dnotq/dnotq_kicad_lib/images/JLCPCB_part-pos_format.png

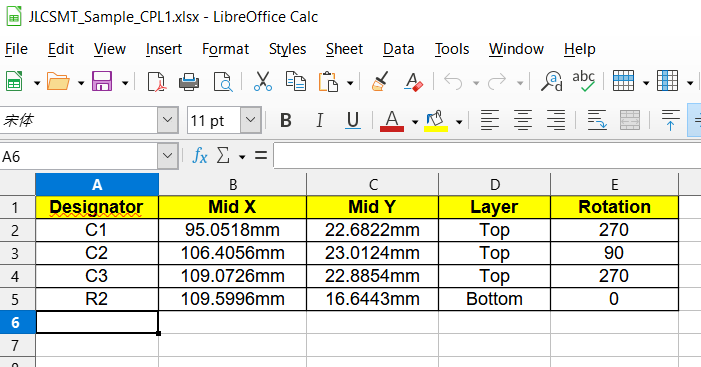
images/JLCPCB_part-pos_format.png
