dnotq/dnotq_kicad_lib/images/kicad_using_sym_foot.png

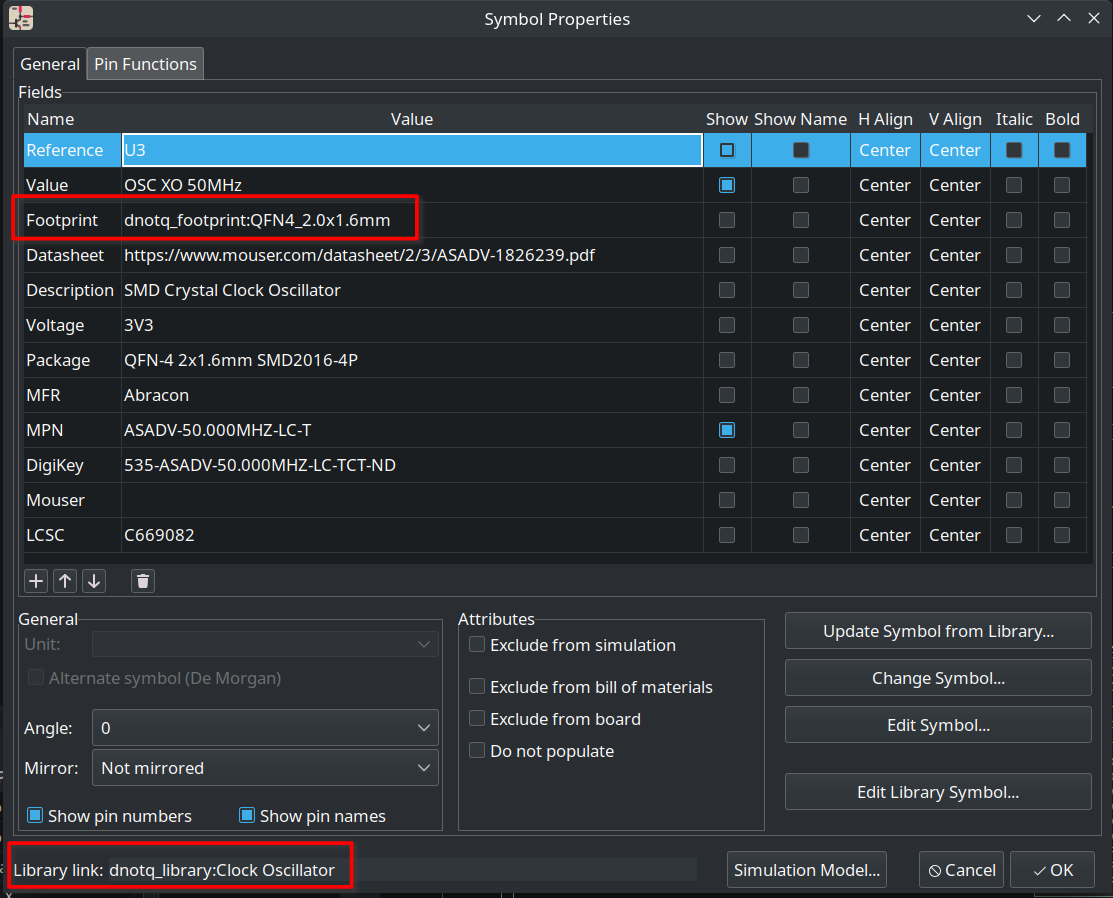
images/kicad_using_sym_foot.png
