dnotq/dnotq_kicad_lib/images/symbol_field_ref.png

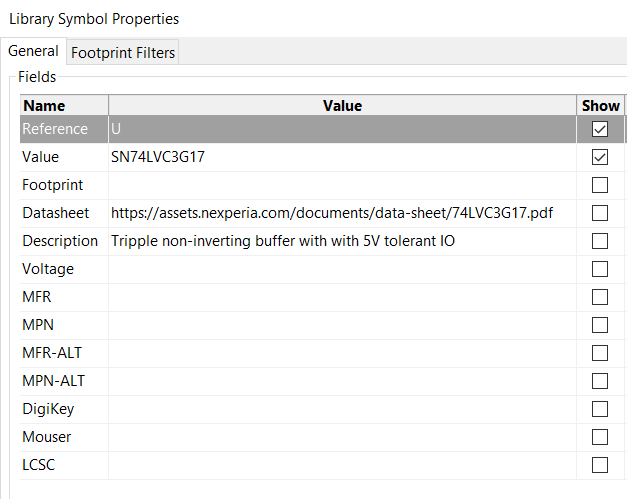
images/symbol_field_ref.png
