dnotq/dnotq_kicad_lib/models/Seiko_Epston_FC-135R_crystal.step

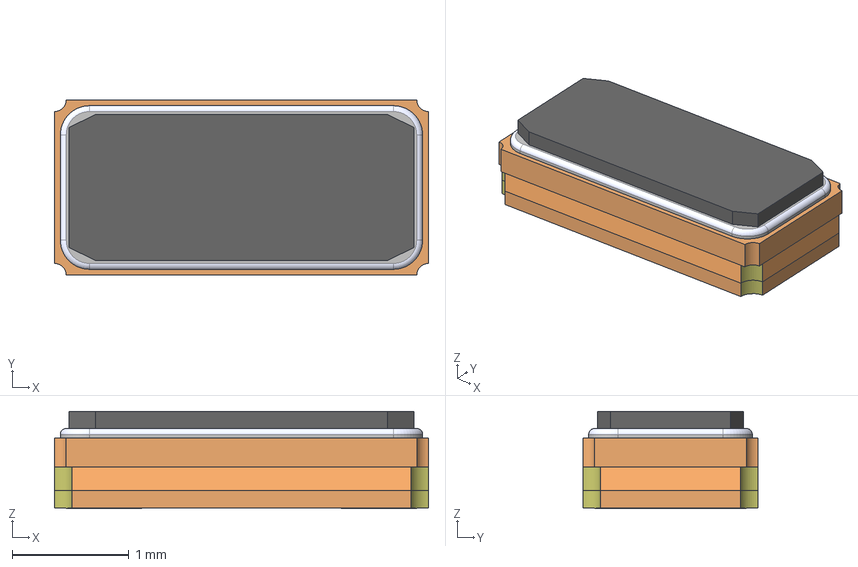
[picture p8: CAD file, 2026-05-12]
models/Seiko_Epston_FC-135R_crystal.step
3.20 x 1.50 x 0.831 mm
FC-135
FC-136
FC-137
FC-138
FC-139
FC-140
FC-141
FC-142
FC-143
FC-144
