dnotq/dnotq_kicad_lib/models/Molex_053261-0271_2pos_1.25mm_ra_smd.step

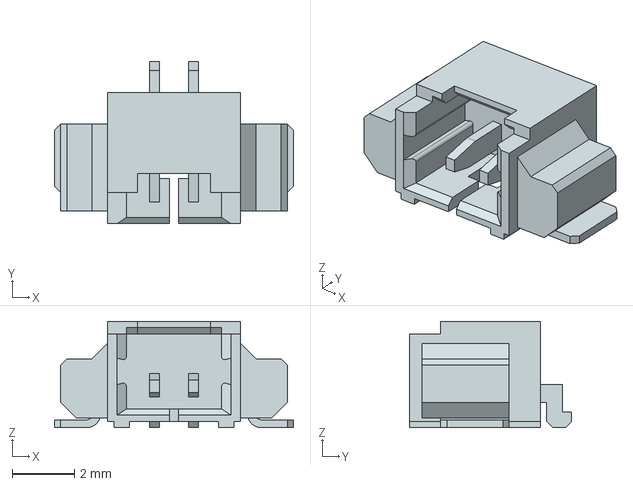
[picture p9: CAD file, 2026-05-12]
models/Molex_053261-0271_2pos_1.25mm_ra_smd.step
7.65 x 5.20 x 3.40 mm
