dnotq/dnotq_kicad_lib/models/Seiko_Epson_MC-306_8x3.8mm.step

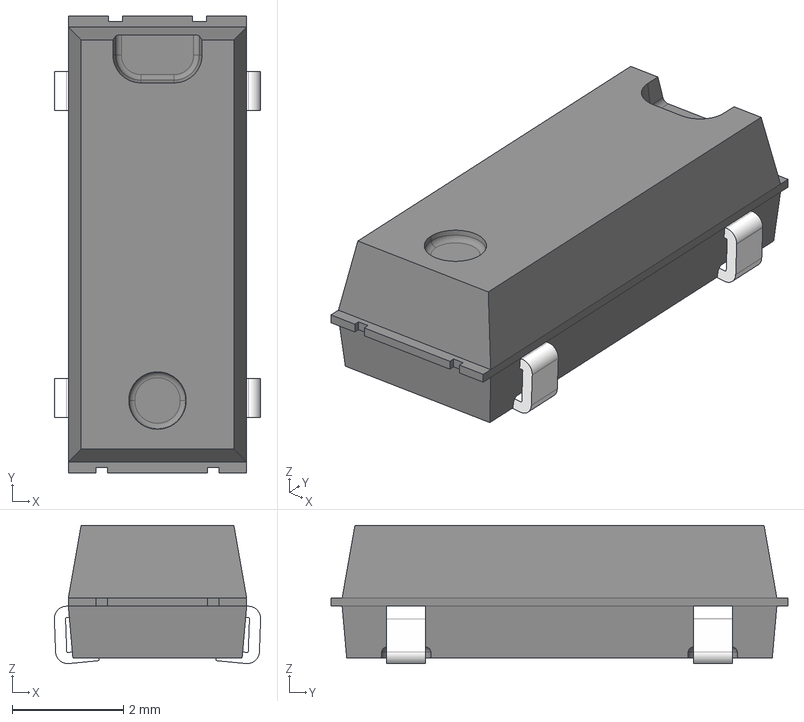
[picture p10: CAD file, 2026-05-12]
models/Seiko_Epson_MC-306_8x3.8mm.step
3.70 x 8.20 x 2.48 mm
