dnotq/dnotq_kicad_lib/models/D_SOD-882.step

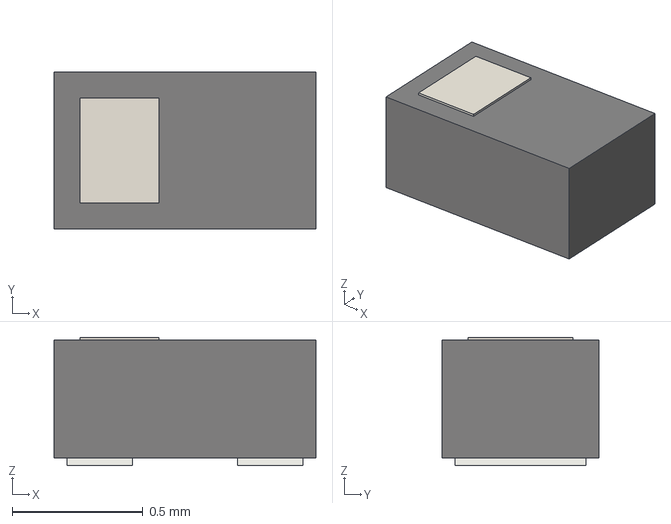
[picture p11: CAD file, 2025-04-14]
models/D_SOD-882.step
1.00 x 0.6 x 0.49 mm
