dnotq/dnotq_kicad_lib/models/VQFP-100_14x14mm_P0.5mm.step

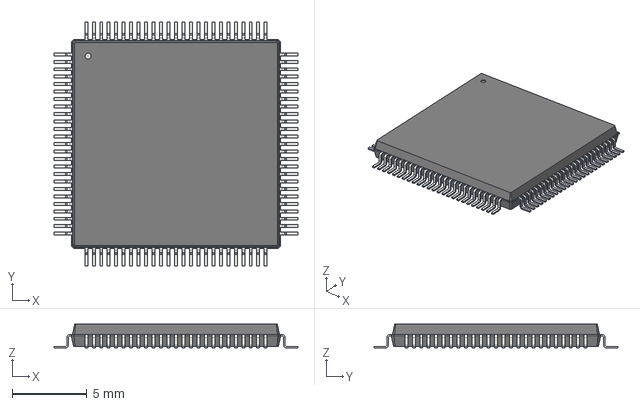
[picture p12: CAD file, 2025-04-14]
models/VQFP-100_14x14mm_P0.5mm.step
16.3 x 16.3 x 1.60 mm
