dnotq/dnotq_kicad_lib/models/C_0201_0603Metric.step

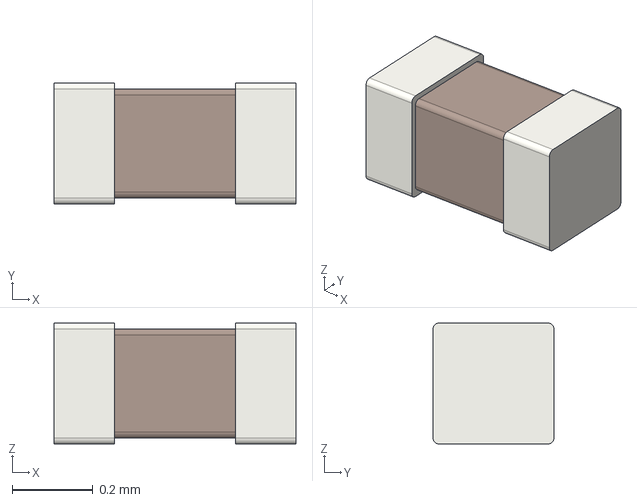
[picture p13: CAD file, 2025-04-14]
models/C_0201_0603Metric.step
0.6 x 0.3 x 0.3 mm
