dnotq/dnotq_kicad_lib/models/SOT-323_SC-70.step

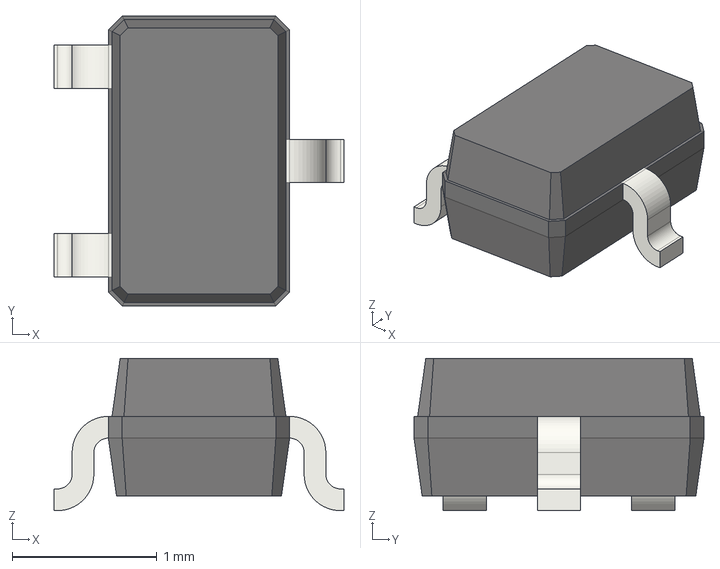
[picture p14: CAD file, 2025-04-14]
models/SOT-323_SC-70.step
2.00 x 2.00 x 1.05 mm
