dnotq/dnotq_kicad_lib/models/R_0603_1608Metric.step

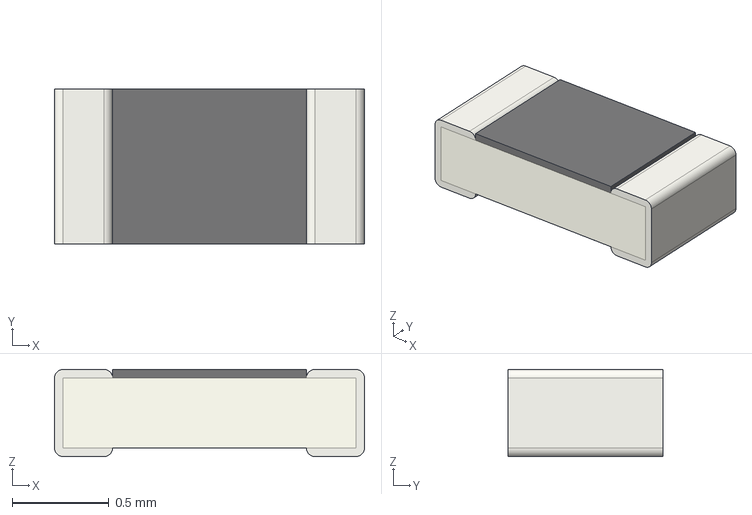
[picture p16: CAD file, 2025-04-14]
models/R_0603_1608Metric.step
1.60 x 0.8 x 0.45 mm
