dnotq/dnotq_kicad_lib/models/WSON-6-1EP_2x2mm_P0.65mm_EP1x1.6mm.step

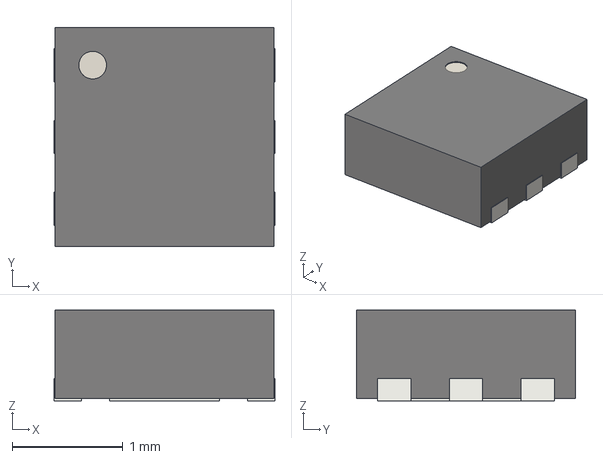
[picture p17: CAD file, 2025-04-14]
models/WSON-6-1EP_2x2mm_P0.65mm_EP1x1.6mm.step
2.00 x 1.98 x 0.82 mm
