dnotq/dnotq_kicad_lib/models/PinSocket_2x06_P2.54mm_Horizontal.step

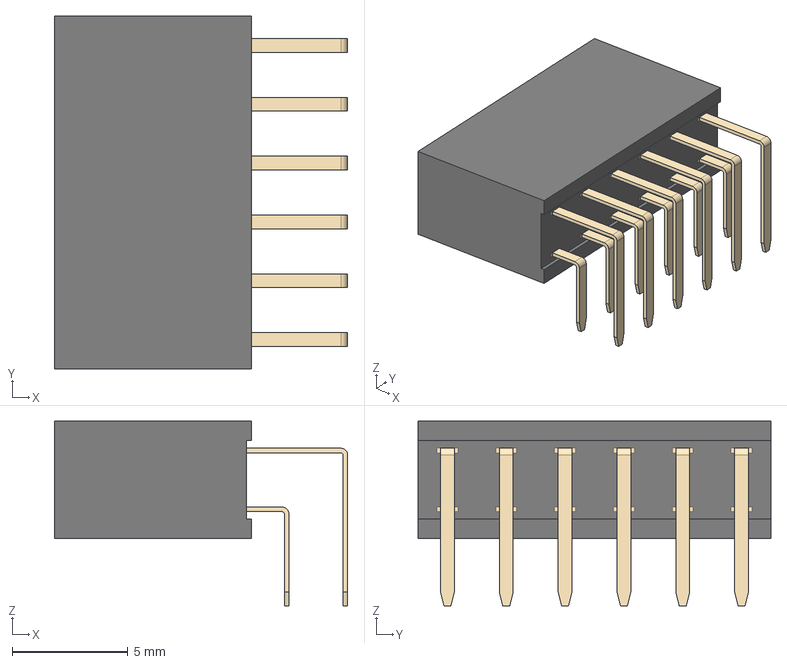
[picture p18: CAD file, 2025-04-14]
models/PinSocket_2x06_P2.54mm_Horizontal.step
12.7 x 15.2 x 7.98 mm
