dnotq/dnotq_kicad_lib/models/R_0612_1632Metric.step

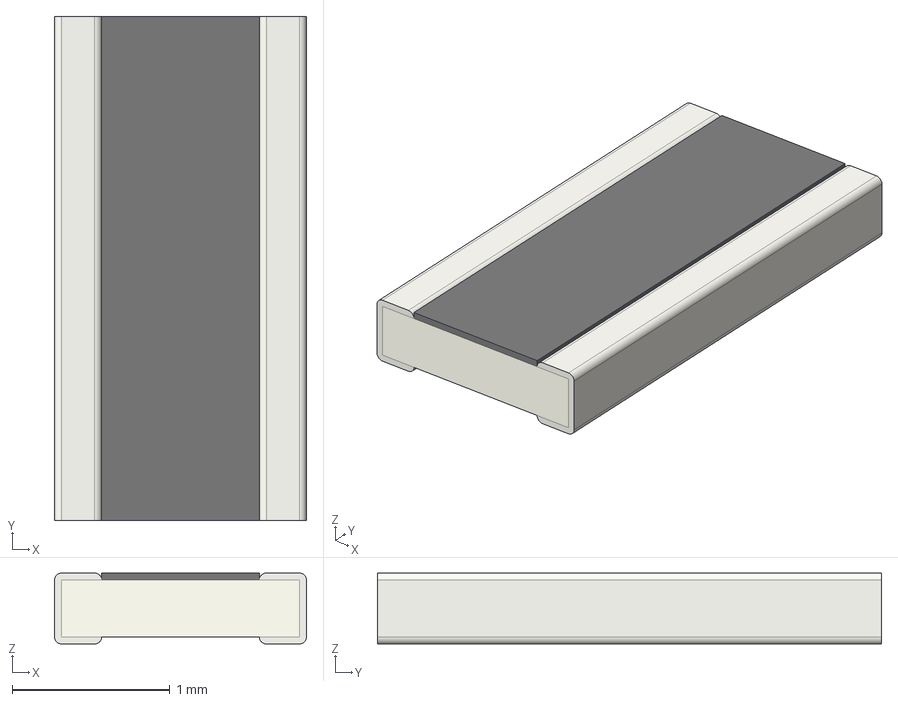
[picture p19: CAD file, 2025-04-14]
models/R_0612_1632Metric.step
1.60 x 3.20 x 0.45 mm
