dnotq/dnotq_kicad_lib/models/C_0402_1005Metric.step

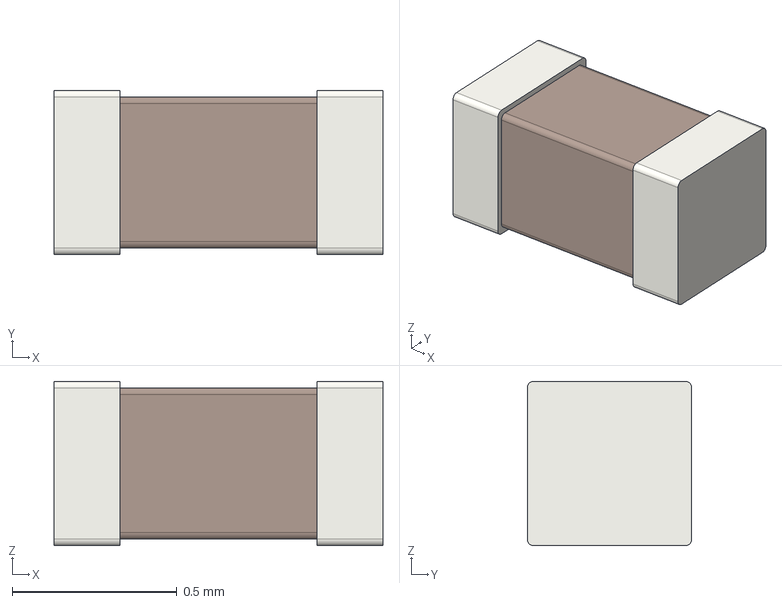
[picture p20: CAD file, 2025-04-14]
models/C_0402_1005Metric.step
1.00 x 0.5 x 0.5 mm
