dnotq/dnotq_kicad_lib/models/VSSOP-8_2.3x2mm_P0.5mm.step

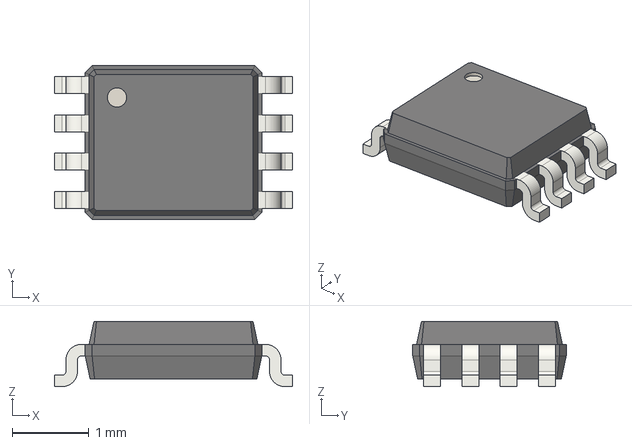
[picture p21: CAD file, 2025-04-14]
models/VSSOP-8_2.3x2mm_P0.5mm.step
3.10 x 2.00 x 0.85 mm
