dnotq/dnotq_kicad_lib/models/SOT-23.step

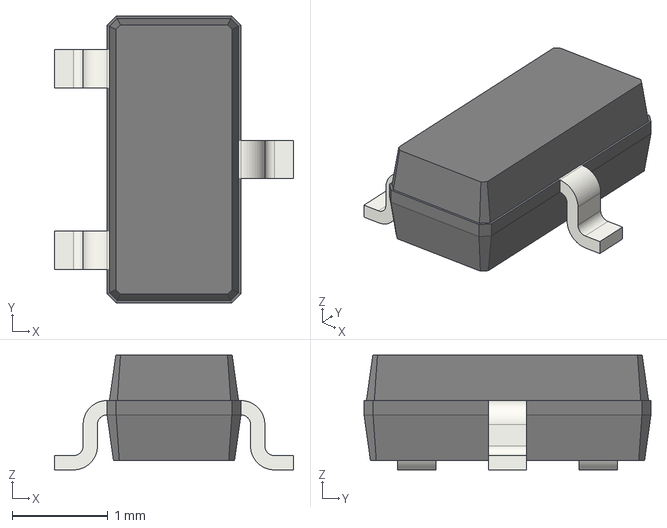
[picture p22: CAD file, 2025-04-14]
models/SOT-23.step
2.50 x 3.00 x 1.20 mm
