dnotq/dnotq_kicad_lib/models/DFN-6_1.2x1.3mm_P0.4mm.step

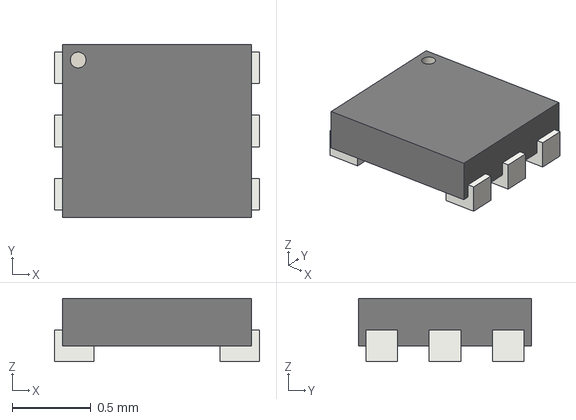
[picture p23: CAD file, 2025-04-14]
models/DFN-6_1.2x1.3mm_P0.4mm.step
1.30 x 1.10 x 0.4 mm
