dnotq/dnotq_kicad_lib/models/R_0402_1005Metric.step

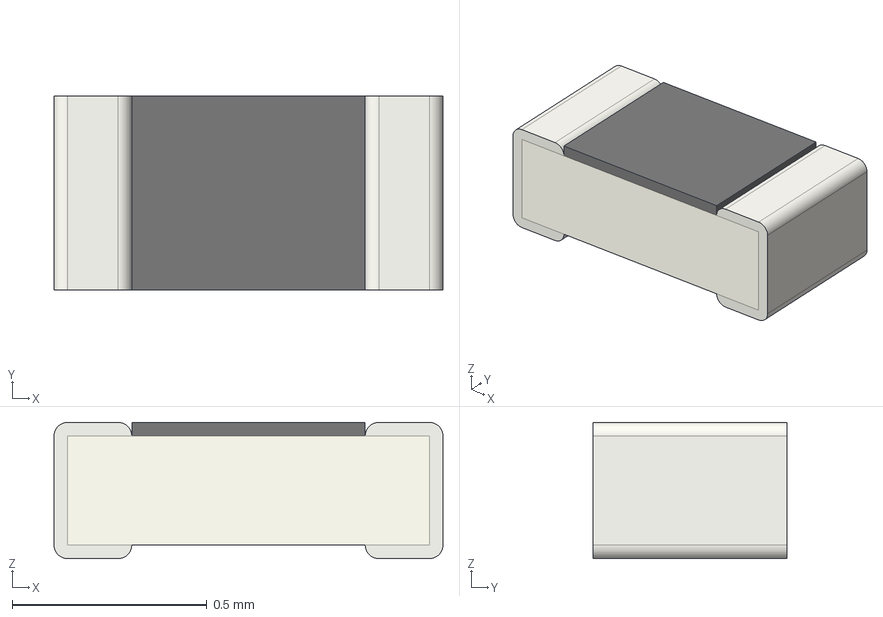
[picture p24: CAD file, 2025-04-14]
models/R_0402_1005Metric.step
1.00 x 0.5 x 0.35 mm
