dnotq/dnotq_kicad_lib/models/C_0603_1608Metric.step

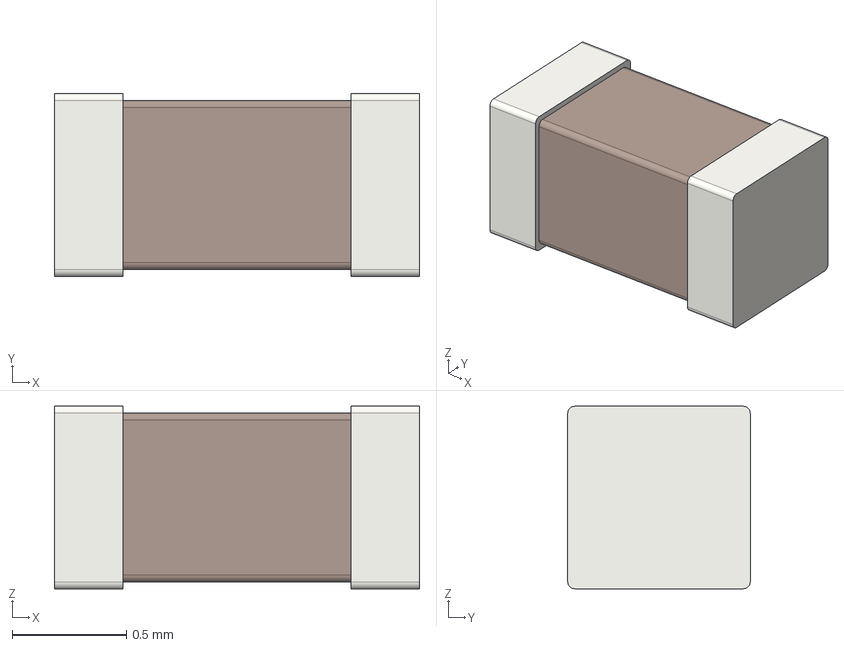
[picture p25: CAD file, 2025-04-14]
models/C_0603_1608Metric.step
1.60 x 0.8 x 0.8 mm
