dnotq/dnotq_kicad_lib/models/R_Array_Convex_4x0402.step

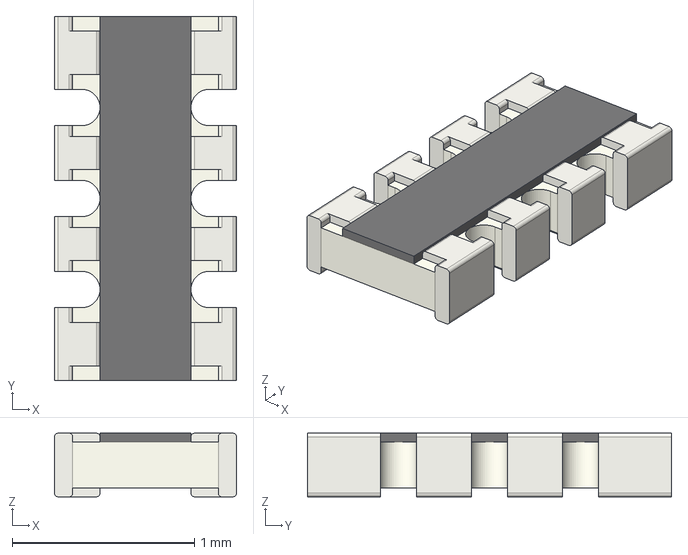
[picture p26: CAD file, 2025-04-14]
models/R_Array_Convex_4x0402.step
1.00 x 2.00 x 0.35 mm
