dnotq/dnotq_kicad_lib/models/R_0201_0603Metric.step

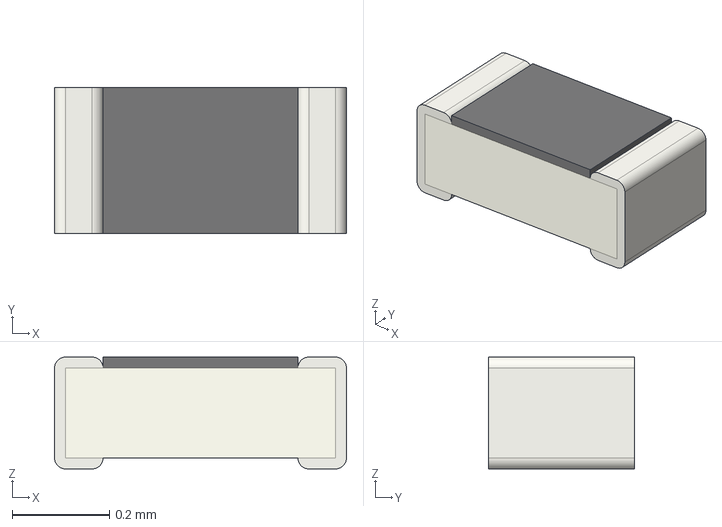
[picture p27: CAD file, 2025-04-14]
models/R_0201_0603Metric.step
0.6 x 0.3 x 0.23 mm
