dnotq/dnotq_kicad_lib/models/TSSOP-20_4.4x6.5mm_P0.65mm.step

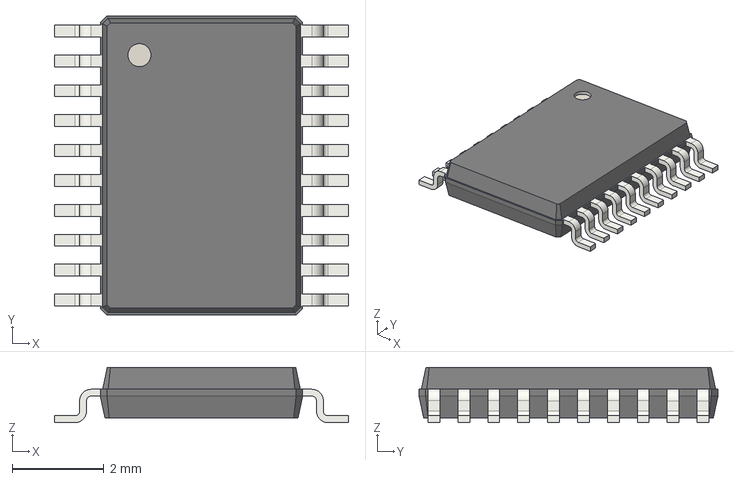
[picture p28: CAD file, 2025-04-14]
models/TSSOP-20_4.4x6.5mm_P0.65mm.step
6.40 x 6.50 x 1.20 mm
