dnotq/dnotq_kicad_lib/models/TQFP-32_7x7mm_P0.8mm.step

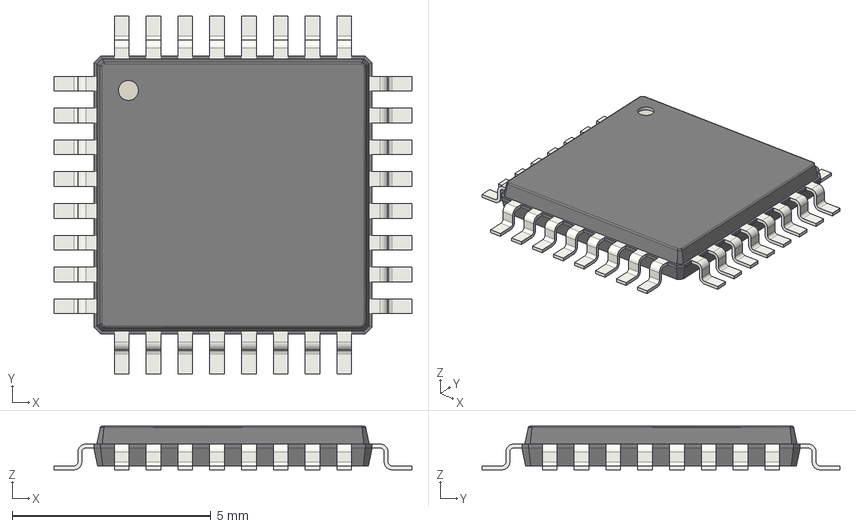
[picture p29: CAD file, 2025-04-14]
models/TQFP-32_7x7mm_P0.8mm.step
9.00 x 9.00 x 1.10 mm
