dnotq/dnotq_kicad_lib/models/USB_Micro-B_Molex_47346-0001.step

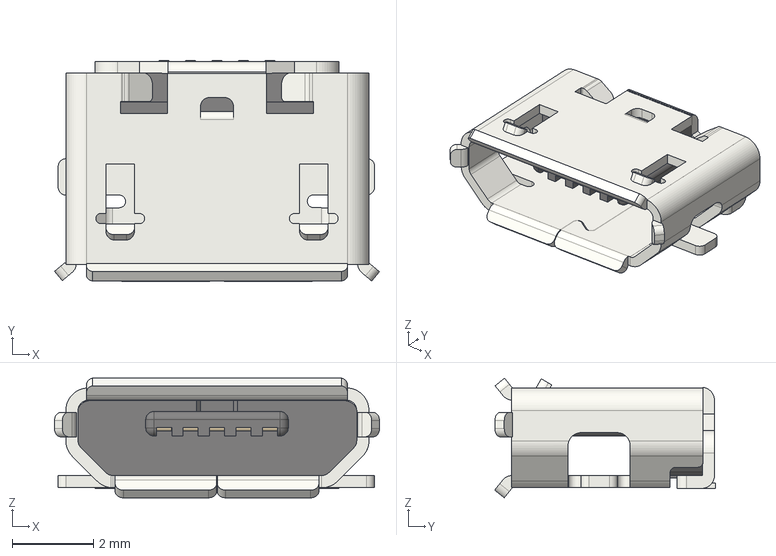
[picture p30: CAD file, 2025-04-14]
models/USB_Micro-B_Molex_47346-0001.step
7.98 x 5.42 x 2.94 mm
