dnotq/dnotq_kicad_lib/models/LED_D3.0mm.step

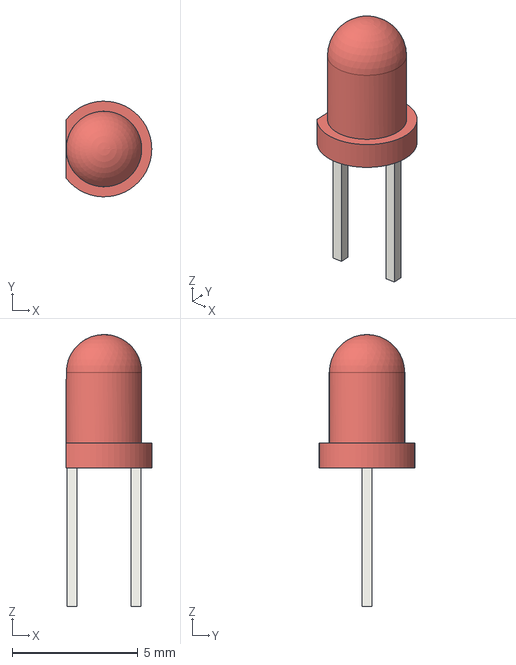
[picture p31: CAD file, 2025-04-14]
models/LED_D3.0mm.step
3.40 x 3.80 x 10.8 mm
