dnotq/dnotq_kicad_lib/models/C_0805_2012Metric.step

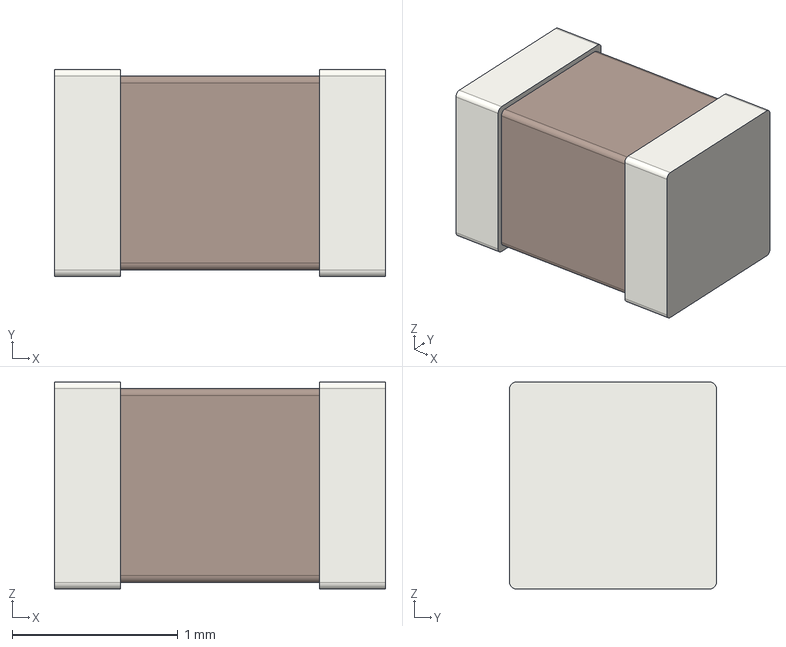
[picture p32: CAD file, 2025-04-14]
models/C_0805_2012Metric.step
2.00 x 1.25 x 1.25 mm
