dnotq/dnotq_kicad_lib/models/D_SOD-523.step

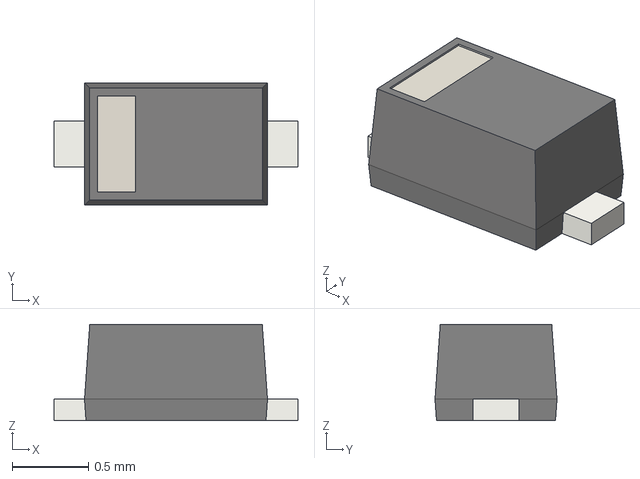
[picture p33: CAD file, 2025-04-14]
models/D_SOD-523.step
1.60 x 0.8 x 0.63 mm
