dnotq/dnotq_kicad_lib/models/TO-263-3_TabPin2.step

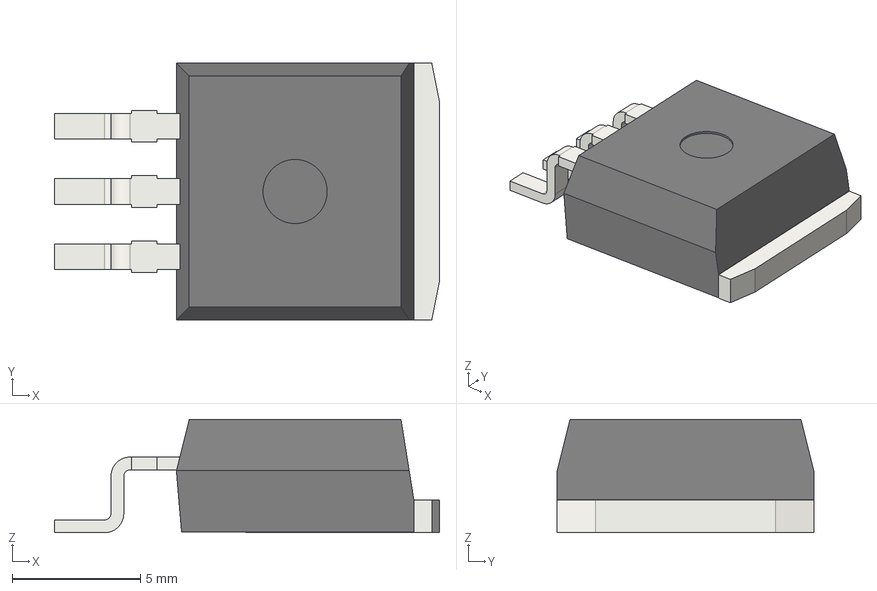
[picture p34: CAD file, 2025-04-14]
models/TO-263-3_TabPin2.step
15.0 x 10.0 x 4.42 mm
a52d3817-9c39-11ed-93f0-dde97e994e83_part
a52d3818-9c39-11ed-93f0-dde97e994e83_part
a52d3819-9c39-11ed-93f0-dde97e994e83_part
