dnotq/dnotq_kicad_lib/models/HIROSE_FH34SRJ-22S-0.5SH.step

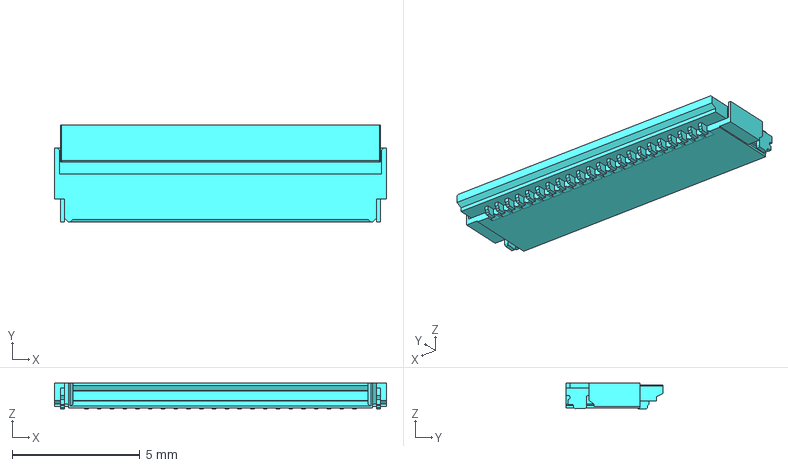
[picture p35: CAD file, 2023-02-13]
models/HIROSE_FH34SRJ-22S-0.5SH.step
13.0 x 3.80 x 1.00 mm
