dnotq/dnotq_kicad_lib/models/3M_TEXTOOL_ZIF_40DIP.step

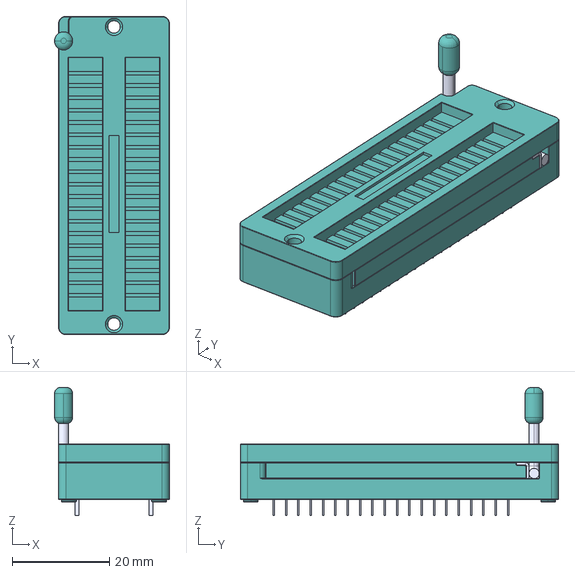
[picture p36: CAD file, 2023-02-13]
models/3M_TEXTOOL_ZIF_40DIP.step
23.7 x 65.5 x 26.4 mm
