dnotq/dnotq_kicad_lib/models/CUI_SJ-3523-SMT-TR.step

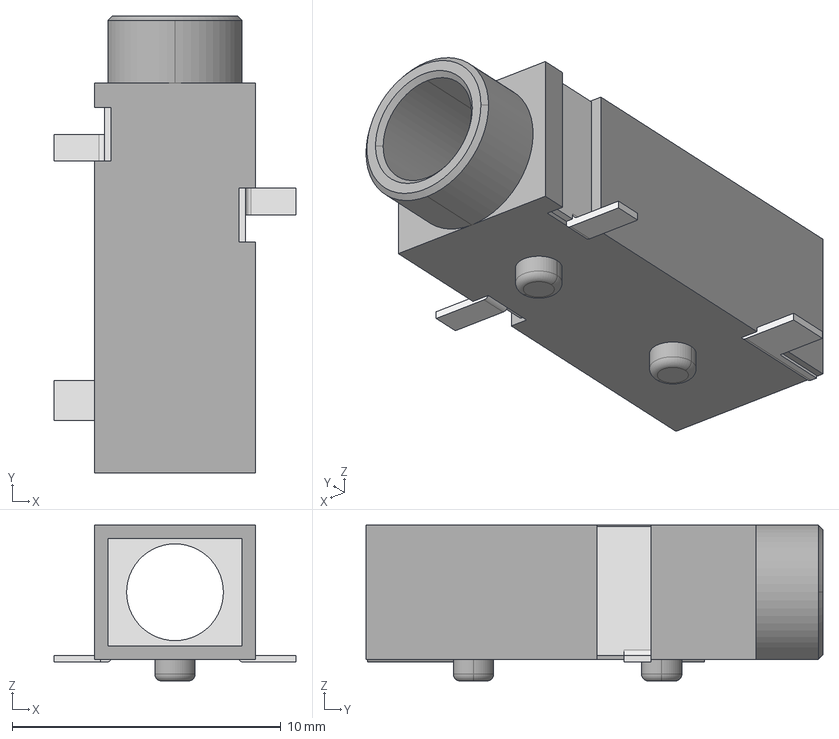
[picture p37: CAD file, 2022-12-09]
models/CUI_SJ-3523-SMT-TR.step
9.00 x 17.0 x 5.80 mm
