dnotq/dnotq_kicad_lib/models/LED_0603_1608Metric.step

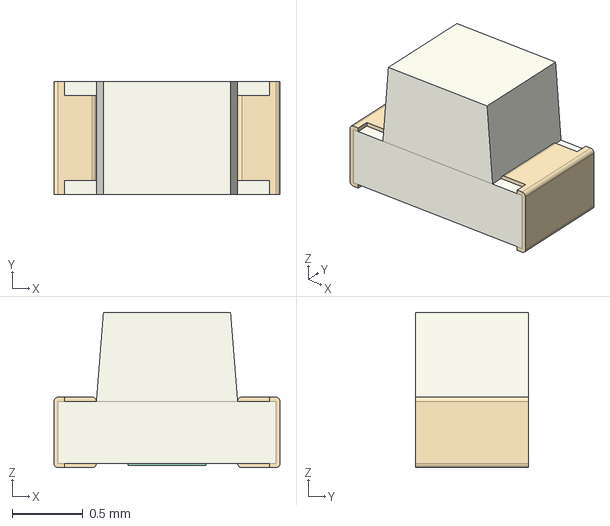
[picture p38: CAD file, 2022-12-09]
models/LED_0603_1608Metric.step
1.60 x 0.8 x 1.10 mm
