dnotq/dnotq_kicad_lib/models/UDFN8_1.95x1.0.step

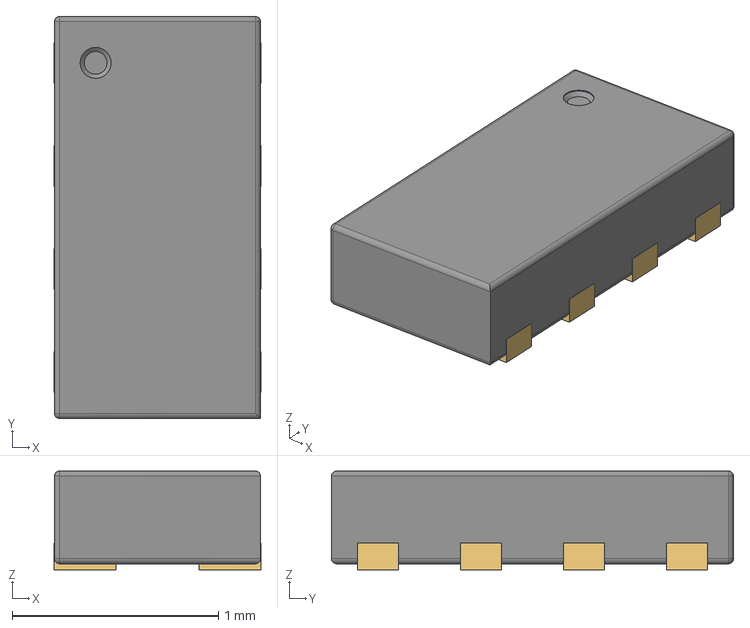
[picture p39: CAD file, 2022-12-09]
models/UDFN8_1.95x1.0.step
1.00 x 1.95 x 0.48 mm
