dnotq/dnotq_kicad_lib/models/VSSOP-8_3.0x3.0mm_P0.65mm.step

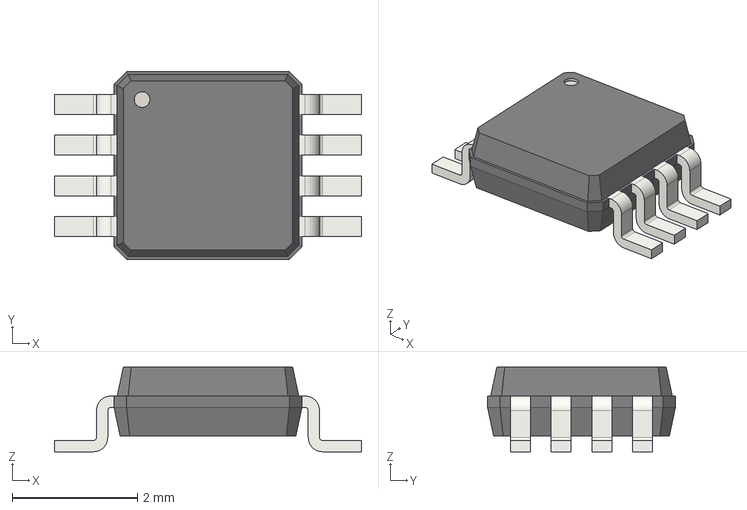
[picture p40: CAD file, 2022-12-09]
models/VSSOP-8_3.0x3.0mm_P0.65mm.step
4.90 x 3.00 x 1.35 mm
