dnotq/dnotq_kicad_lib/models/molex_FFC_20_P0.5.step

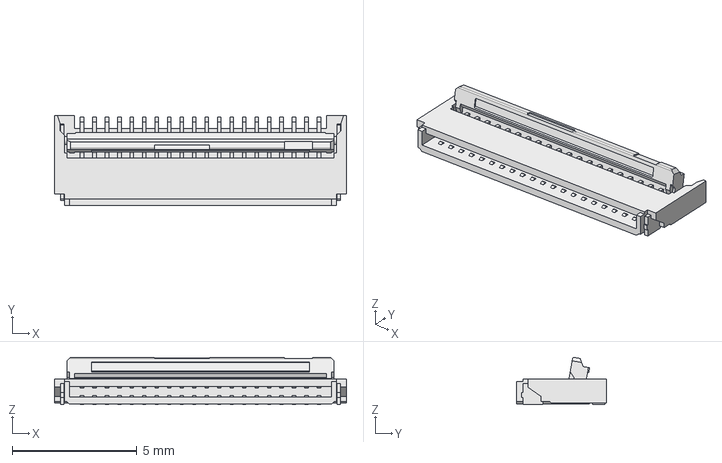
[picture p41: CAD file, 2022-12-09]
models/molex_FFC_20_P0.5.step
11.7 x 3.60 x 1.90 mm
