dnotq/dnotq_kicad_lib/models/PVQFN-N24.step

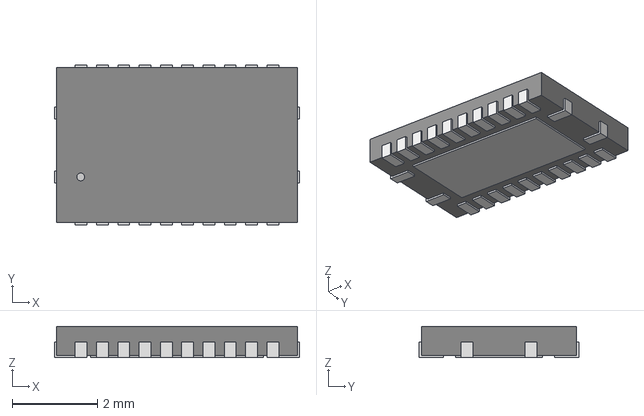
[picture p42: CAD file, 2022-12-09]
models/PVQFN-N24.step
5.75 x 3.75 x 0.739 mm
