dnotq/dnotq_kicad_lib/models/EDAC_DSUB_HD15_THIN_FEMALE.step

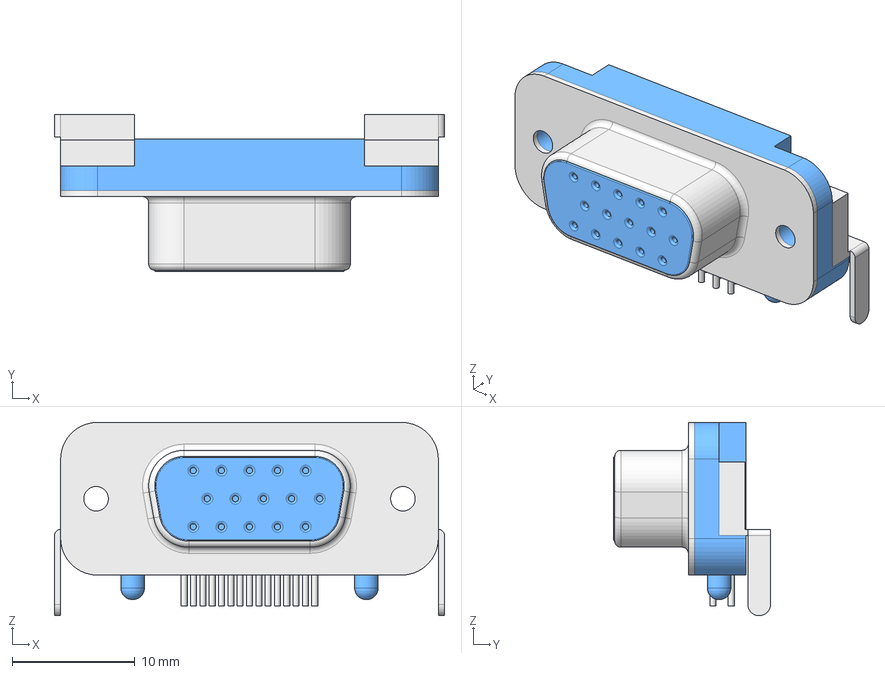
[picture p43: CAD file, 2022-12-09]
models/EDAC_DSUB_HD15_THIN_FEMALE.step
31.8 x 12.8 x 15.7 mm
