dnotq/dnotq_kicad_lib/models/SMD_DIP4.step

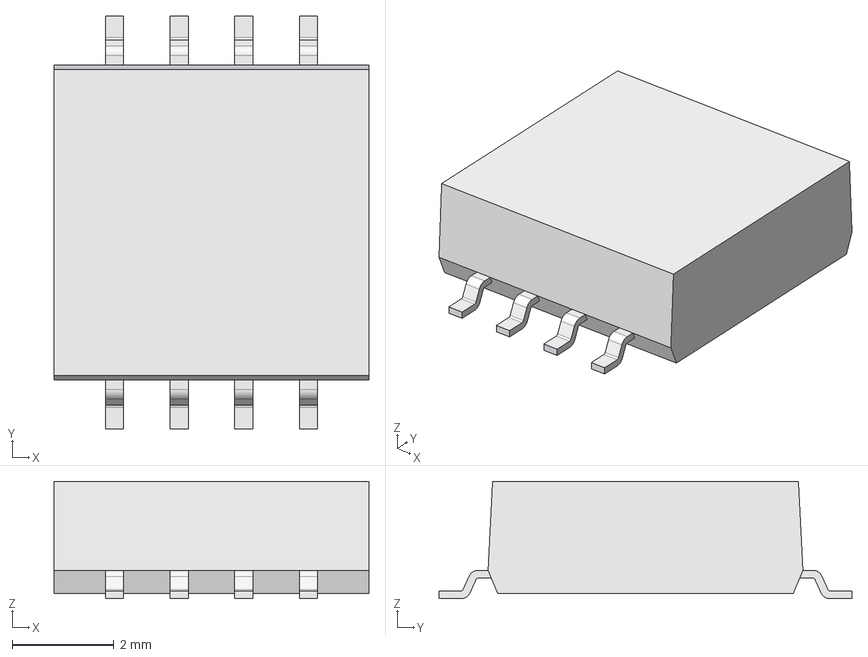
[picture p44: CAD file, 2022-12-09]
models/SMD_DIP4.step
6.20 x 8.13 x 2.31 mm
