dnotq/dnotq_kicad_lib/models/MOLEX_FPC-22_P0.5.step

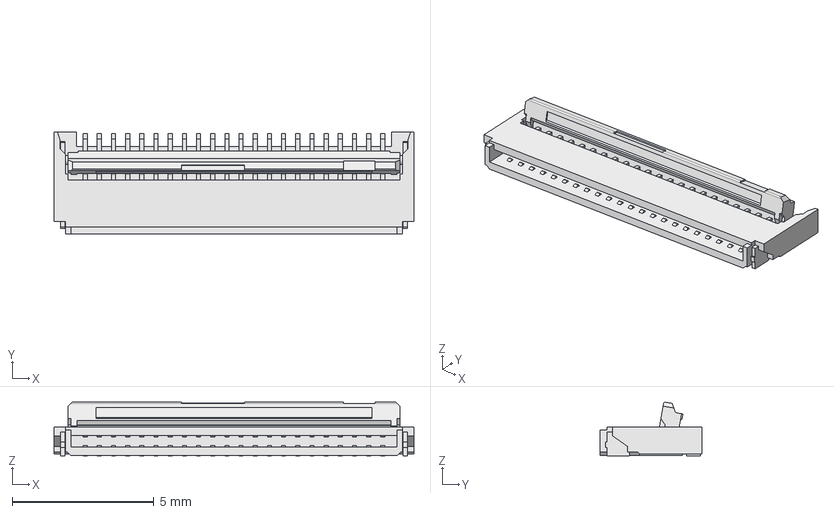
[picture p45: CAD file, 2022-12-09]
models/MOLEX_FPC-22_P0.5.step
12.7 x 3.60 x 1.89 mm
