dnotq/dnotq_kicad_lib/models/CK_SWITCH_101M2S3CQE011.step

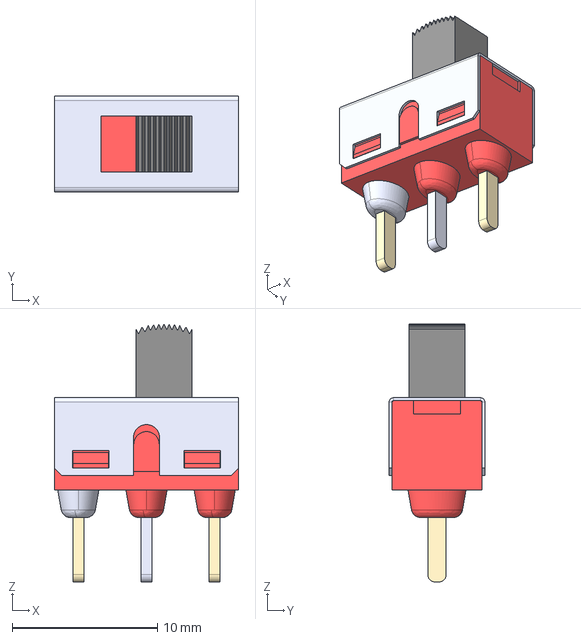
[picture p46: CAD file, 2022-12-09]
models/CK_SWITCH_101M2S3CQE011.step
12.7 x 6.60 x 17.8 mm
