dnotq/dnotq_kicad_lib/models/amp_fci_tmds_type_a.step

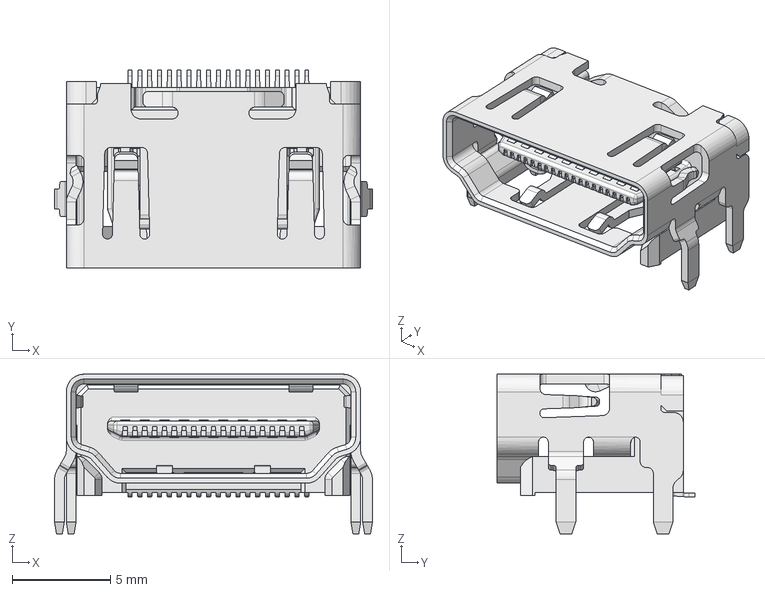
[picture p47: CAD file, 2022-12-09]
models/amp_fci_tmds_type_a.step
16.2 x 10.1 x 8.13 mm
