dnotq/dnotq_kicad_lib/models/TSSOP-8_4.4x3mm_P0.65mm.step

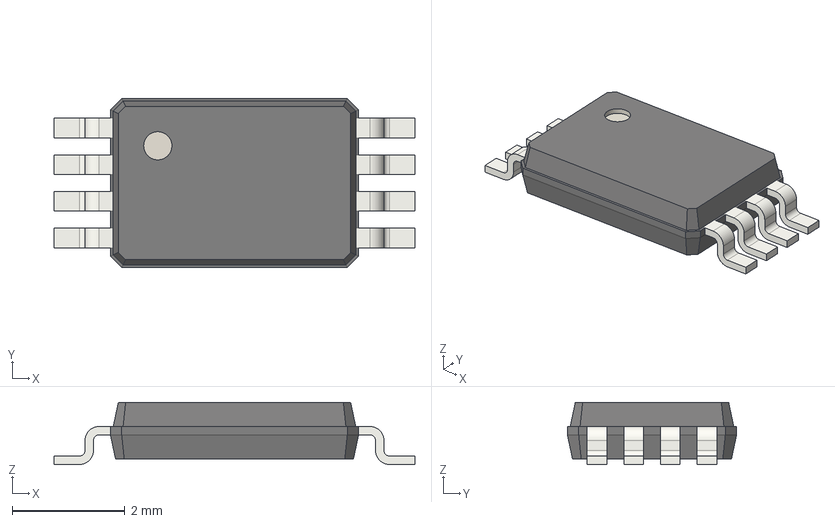
[picture p48: CAD file, 2022-12-09]
models/TSSOP-8_4.4x3mm_P0.65mm.step
6.40 x 3.00 x 1.10 mm
