dnotq/dnotq_kicad_lib/models/TSM_102_01_L_SH_A_cp.step

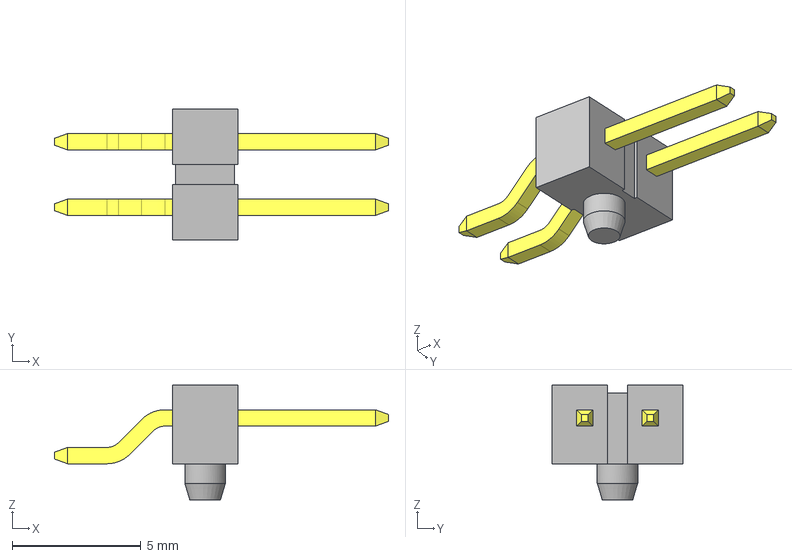
[picture p49: CAD file, 2022-12-09]
models/TSM_102_01_L_SH_A_cp.step
13.0 x 5.08 x 4.45 mm
