dnotq/dnotq_kicad_lib/models/wurth_tact_switch_SPST-NO.step

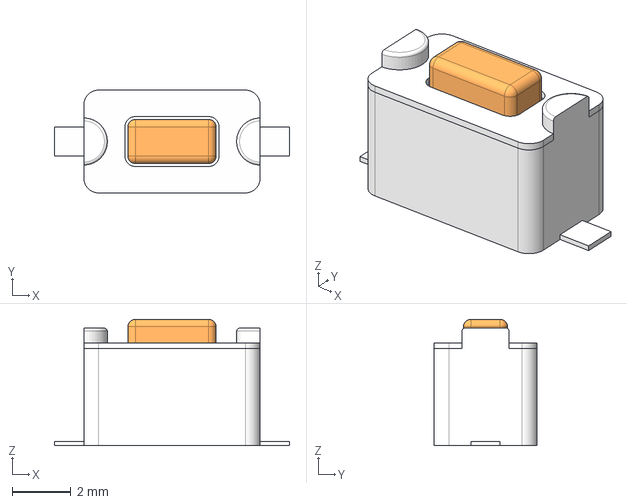
[picture p50: CAD file, 2022-12-09]
models/wurth_tact_switch_SPST-NO.step
8.00 x 3.50 x 4.30 mm
