dnotq/dnotq_kicad_lib/models/ASE_QFN4_3.2x2.5.step

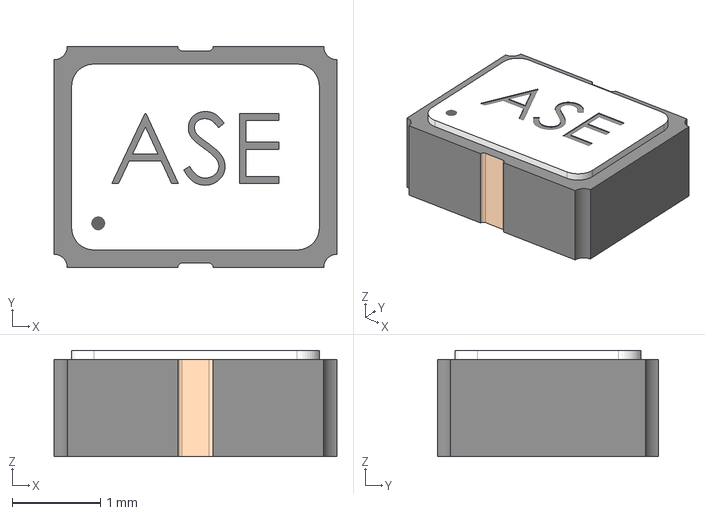
[picture p51: CAD file, 2022-12-09]
models/ASE_QFN4_3.2x2.5.step
3.20 x 2.50 x 1.20 mm
