dnotq/dnotq_kicad_lib/models/Keystone_621.step

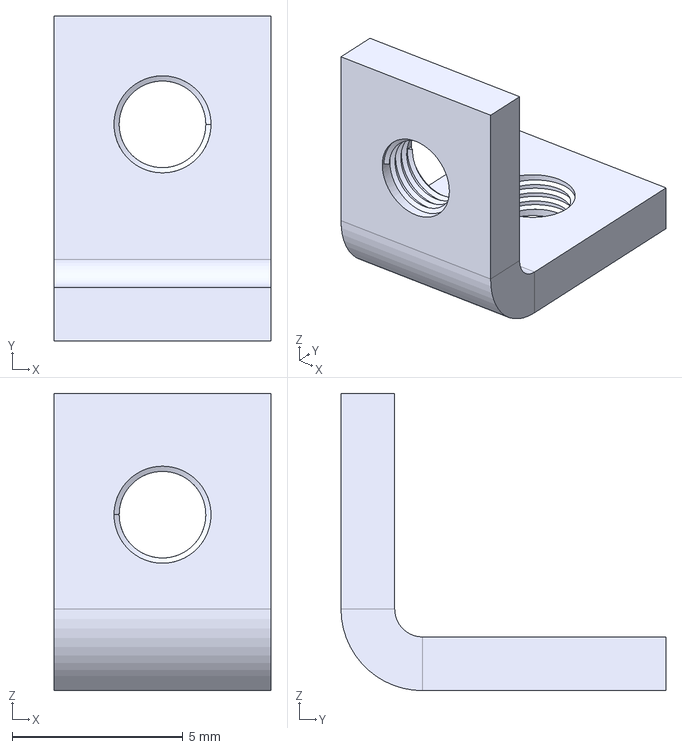
[picture p52: CAD file, 2022-12-09]
models/Keystone_621.step
6.35 x 9.53 x 8.71 mm
