dnotq/dnotq_kicad_lib/models/DSBGA-8_YZT.step

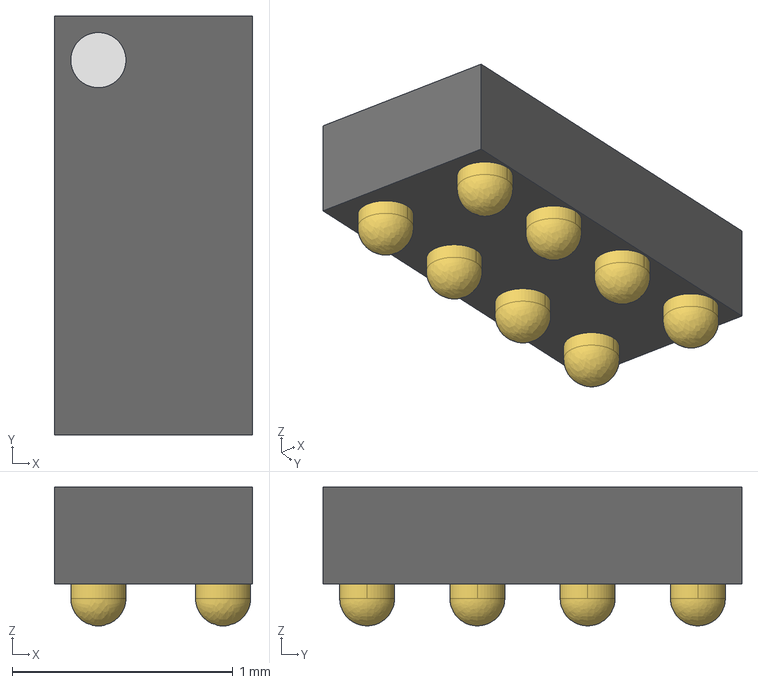
[picture p53: CAD file, 2022-12-09]
models/DSBGA-8_YZT.step
0.9 x 1.90 x 0.63 mm
