dnotq/dnotq_kicad_lib/models/JST_ZH_S2B-ZR-SM4A-TF.step

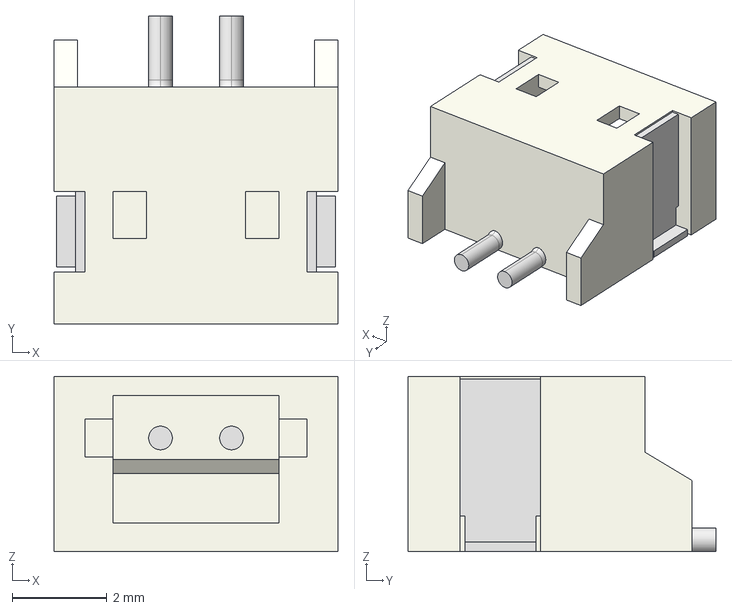
[picture p54: CAD file, 2022-12-09]
models/JST_ZH_S2B-ZR-SM4A-TF.step
6.00 x 6.50 x 3.70 mm
