dnotq/dnotq_kicad_lib/models/DIP24-PCB-PINS.step

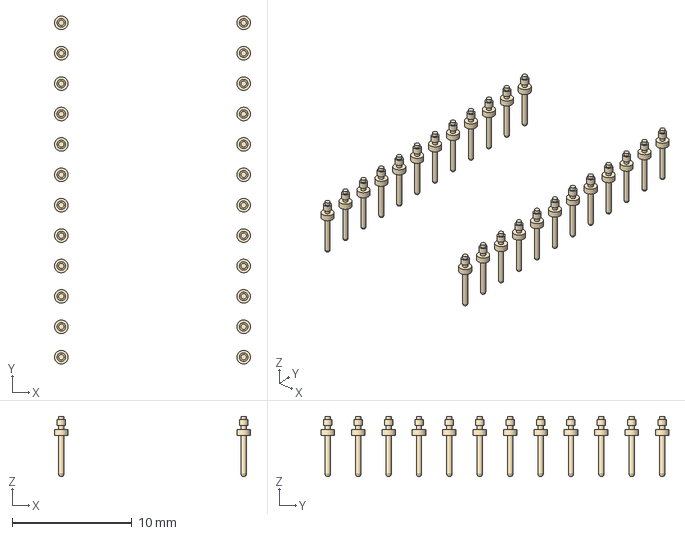
[picture p55: CAD file, 2022-12-09]
models/DIP24-PCB-PINS.step
16.4 x 29.1 x 5.05 mm
