dnotq/dnotq_kicad_lib/models/TSOT-23-6.step

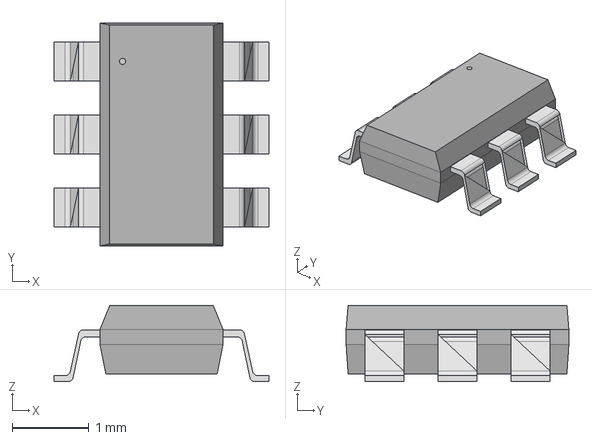
[picture p56: CAD file, 2022-12-09]
models/TSOT-23-6.step
2.79 x 2.90 x 0.993 mm
