dnotq/dnotq_kicad_lib/models/TFBGA_36and48_6x8mm.step

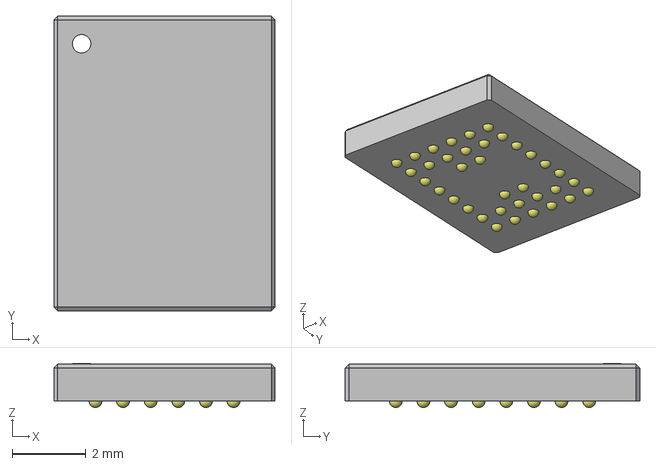
[picture p57: CAD file, 2022-12-09]
models/TFBGA_36and48_6x8mm.step
6.00 x 8.00 x 1.20 mm
