dnotq/dnotq_kicad_lib/models/HDMI_MICRO_TYPE_D.step

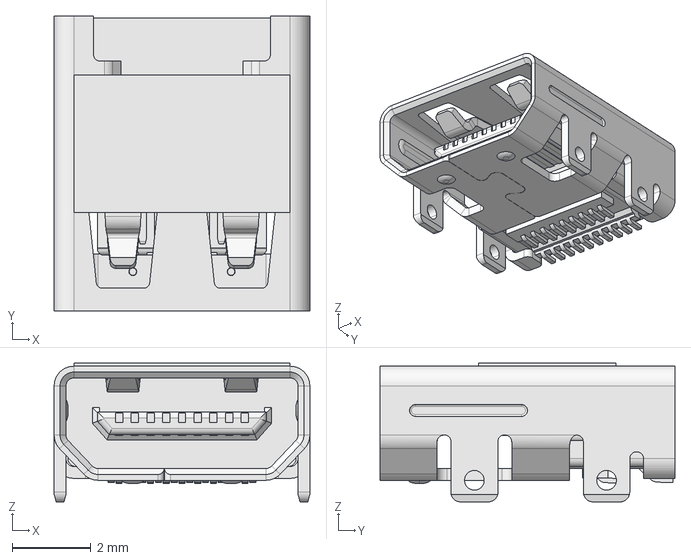
[picture p58: CAD file, 2022-12-09]
models/HDMI_MICRO_TYPE_D.step
6.50 x 7.50 x 3.53 mm
