dnotq/dnotq_kicad_lib/models/JST_SH_SM02B-SRSS-TB.step

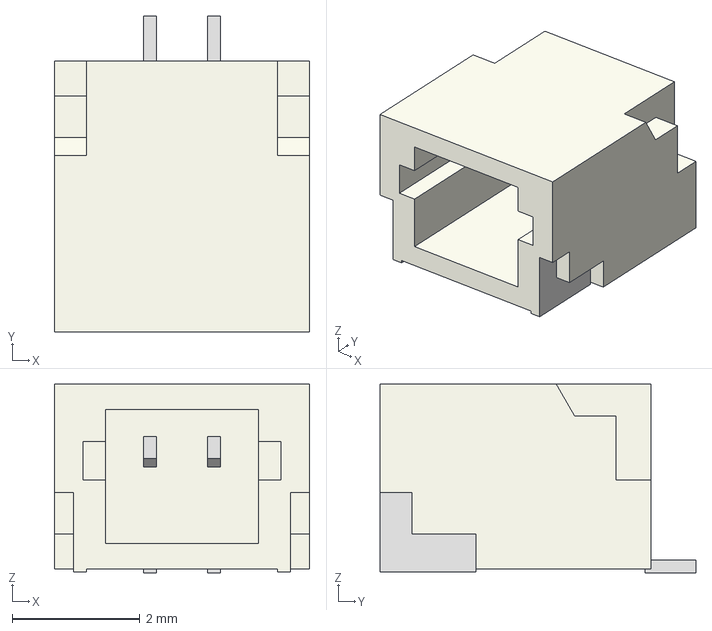
[picture p59: CAD file, 2022-12-09]
models/JST_SH_SM02B-SRSS-TB.step
4.00 x 4.95 x 2.96 mm
