dnotq/dnotq_kicad_lib/models/DSUB-HD15-30X5MM.step

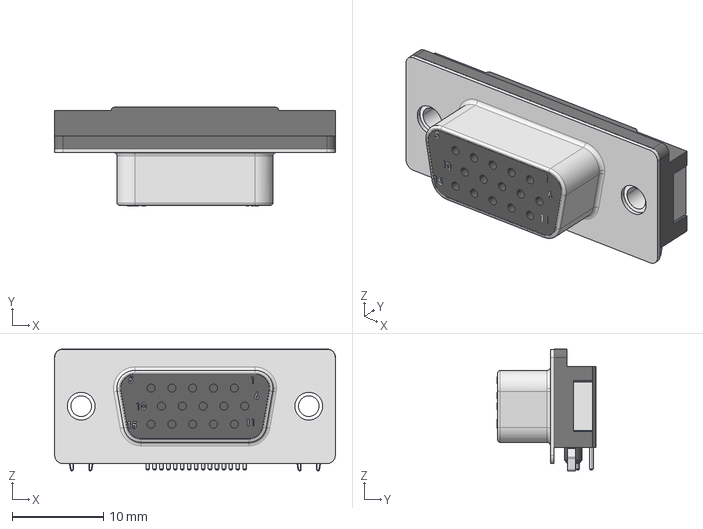
[picture p60: CAD file, 2022-12-09]
models/DSUB-HD15-30X5MM.step
30.9 x 10.8 x 13.4 mm
