dnotq/dnotq_kicad_lib/models/ASA_QFN_2.0x1.6.step

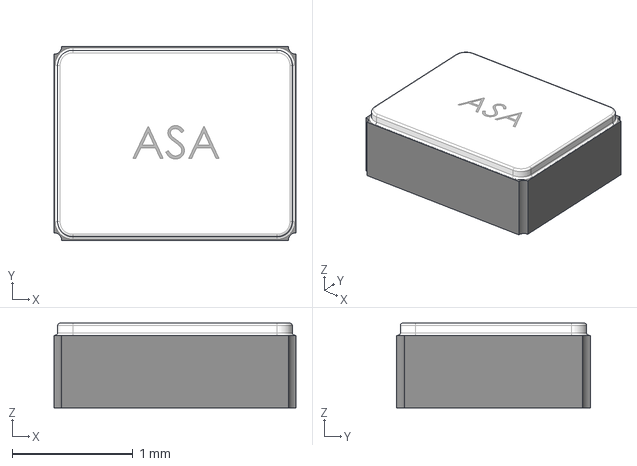
[picture p61: CAD file, 2022-12-09]
models/ASA_QFN_2.0x1.6.step
2.00 x 1.60 x 0.7 mm
