dnotq/dnotq_kicad_lib/models/QFN-32-1EP_4x4mm_P0.4mm_EP2.65x2.65mm.step

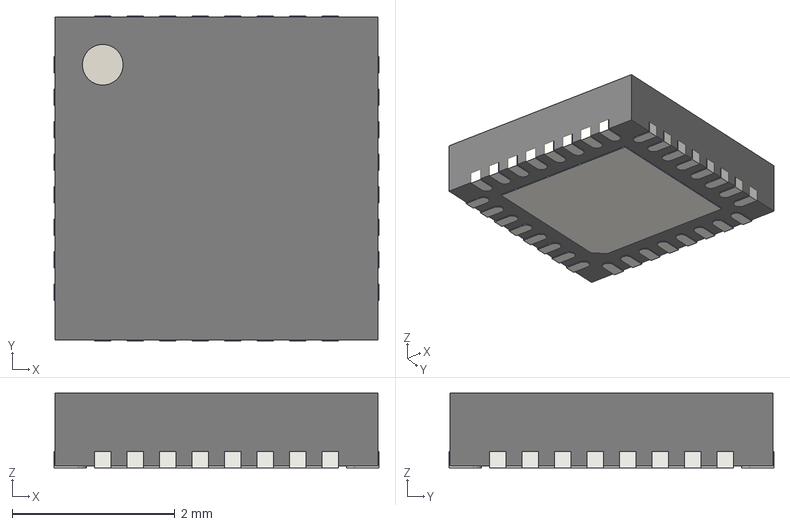
[picture p62: CAD file, 2022-12-09]
models/QFN-32-1EP_4x4mm_P0.4mm_EP2.65x2.65mm.step
4.00 x 4.00 x 0.92 mm
