dnotq/dnotq_kicad_lib/models/D_SOD-323.step

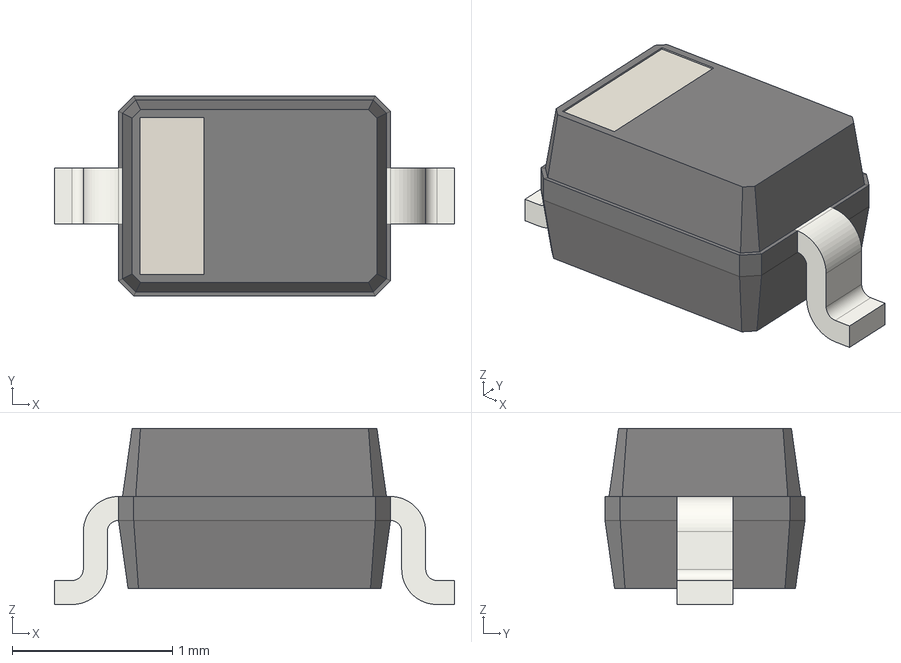
[picture p63: CAD file, 2022-12-09]
models/D_SOD-323.step
2.50 x 1.25 x 1.10 mm
