dnotq/dnotq_kicad_lib/models/TSSOP-8_3x2.8mm_p0.65mm.step

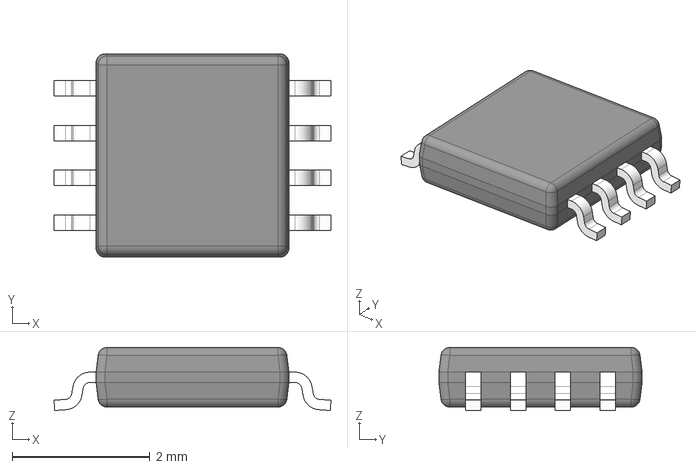
[picture p64: CAD file, 2022-12-09]
models/TSSOP-8_3x2.8mm_p0.65mm.step
4.02 x 2.95 x 0.915 mm
BODY-SO
LEAD-SO x 8
