dnotq/dnotq_kicad_lib/models/WLCSP-6.step

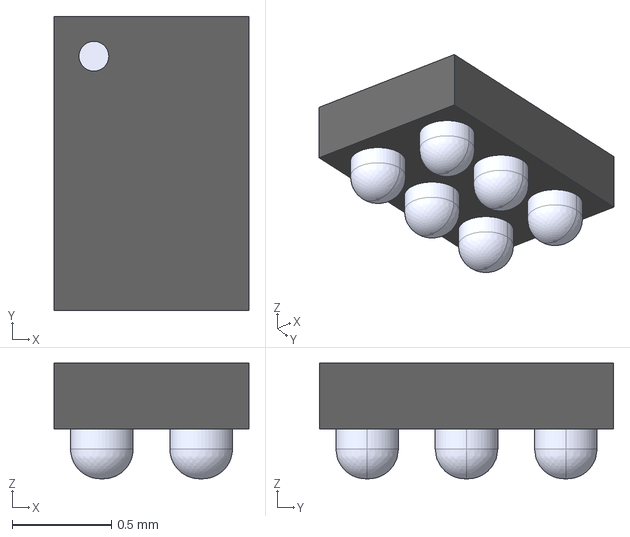
[picture p65: CAD file, 2022-12-09]
models/WLCSP-6.step
0.98 x 1.48 x 0.582 mm
