dnotq/dnotq_kicad_lib/models/R_0805_2012Metric.step

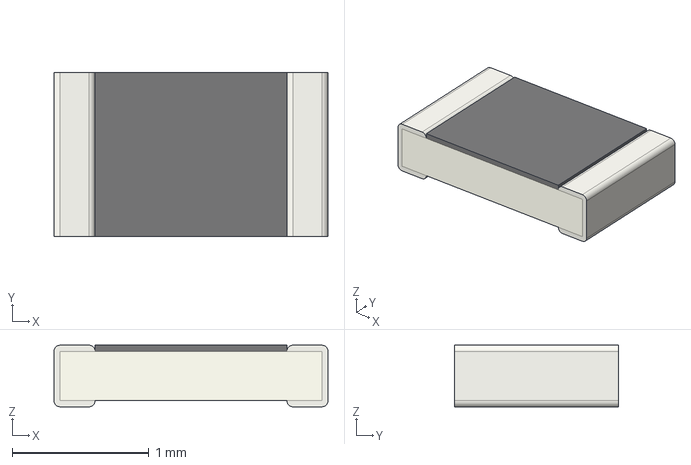
[picture p66: CAD file, 2022-12-09]
models/R_0805_2012Metric.step
2.00 x 1.20 x 0.45 mm
