dnotq/dnotq_kicad_lib/models/SOT-353_SC-70-5.step

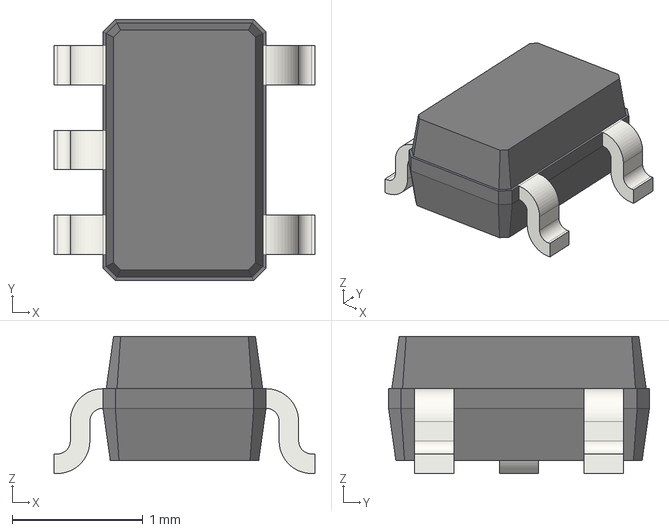
[picture p67: CAD file, 2022-12-09]
models/SOT-353_SC-70-5.step
2.00 x 2.00 x 1.05 mm
