dnotq/dnotq_kicad_lib/models/Crystal_SMD_3215_2Pin_3_2x1_5mm.step

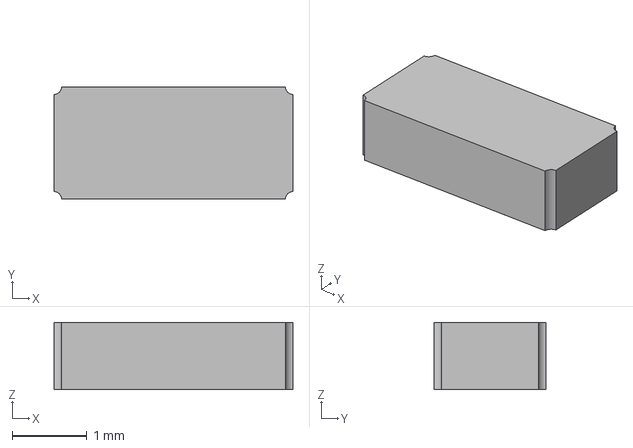
[picture p68: CAD file, 2022-12-09]
models/Crystal_SMD_3215_2Pin_3_2x1_5mm.step
3.20 x 1.50 x 0.9 mm
