dnotq/dnotq_kicad_lib/models/Molex_2x7_2mm_header.step

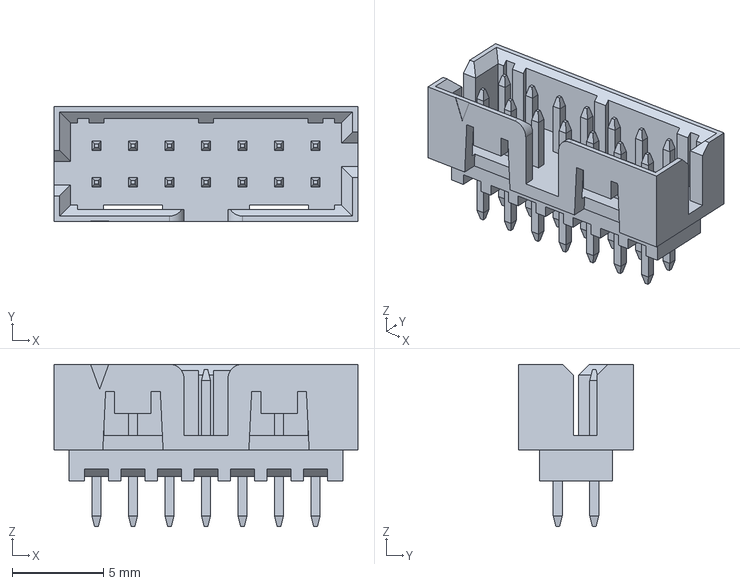
[picture p69: CAD file, 2022-12-09]
models/Molex_2x7_2mm_header.step
16.6 x 6.30 x 8.90 mm
