dnotq/dnotq_kicad_lib/models/TSSOP-8_3x3mm_P0.65mm.step

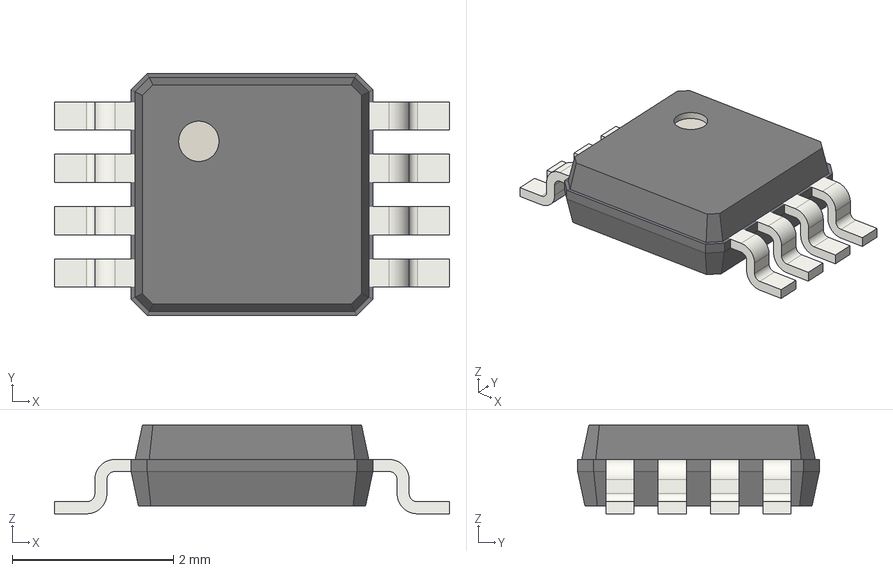
[picture p70: CAD file, 2022-12-09]
models/TSSOP-8_3x3mm_P0.65mm.step
4.90 x 3.00 x 1.10 mm
