dnotq/dnotq_kicad_lib/models/BatteryHolder_Keystone_3034_1x20mm.step

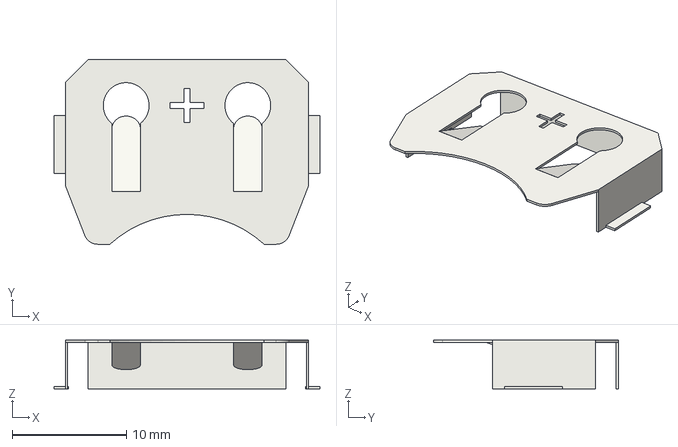
[picture p71: CAD file, 2022-12-09]
models/BatteryHolder_Keystone_3034_1x20mm.step
23.2 x 16.1 x 4.26 mm
