dnotq/dnotq_kicad_lib/models/SOT-23-5.step

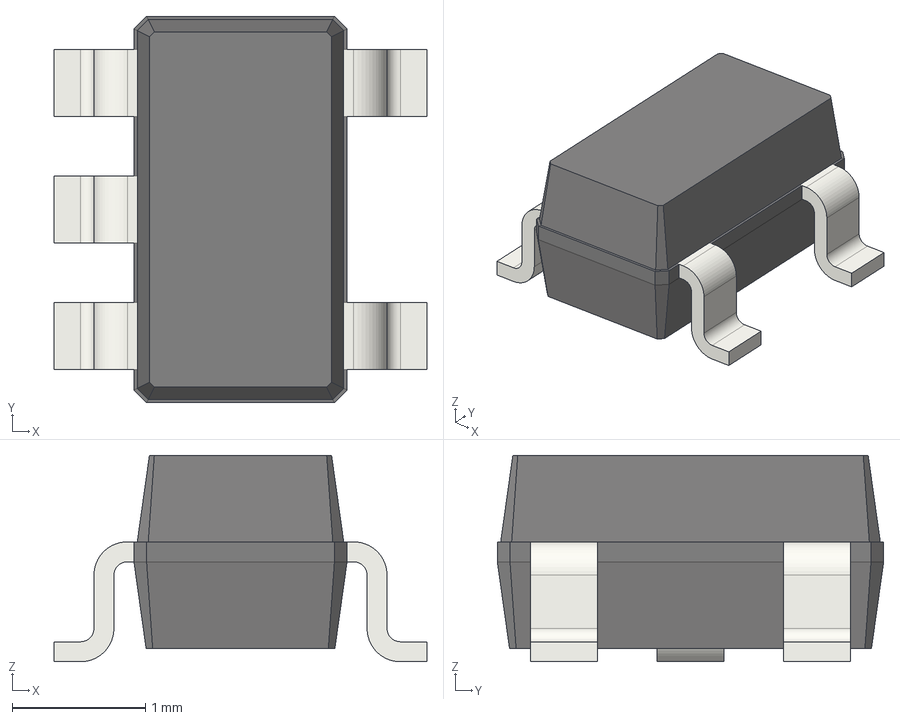
[picture p72: CAD file, 2022-12-09]
models/SOT-23-5.step
2.80 x 2.90 x 1.55 mm
