dnotq/dnotq_kicad_lib/models/MOLEX_HDMI_TYPE_D_SMD.step

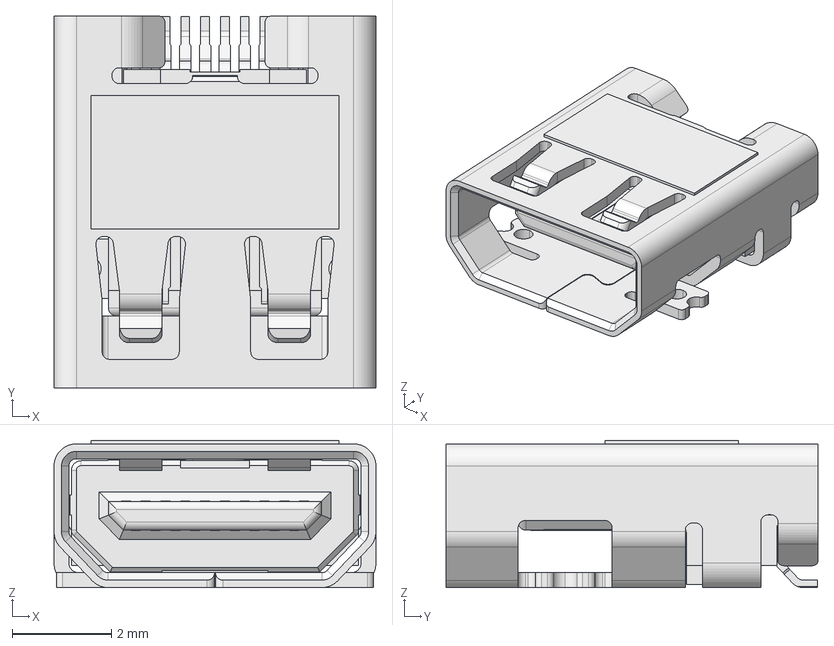
[picture p73: CAD file, 2022-12-09]
models/MOLEX_HDMI_TYPE_D_SMD.step
6.50 x 7.50 x 2.97 mm
