dnotq/dnotq_kicad_lib/models/VSSOP-8.step

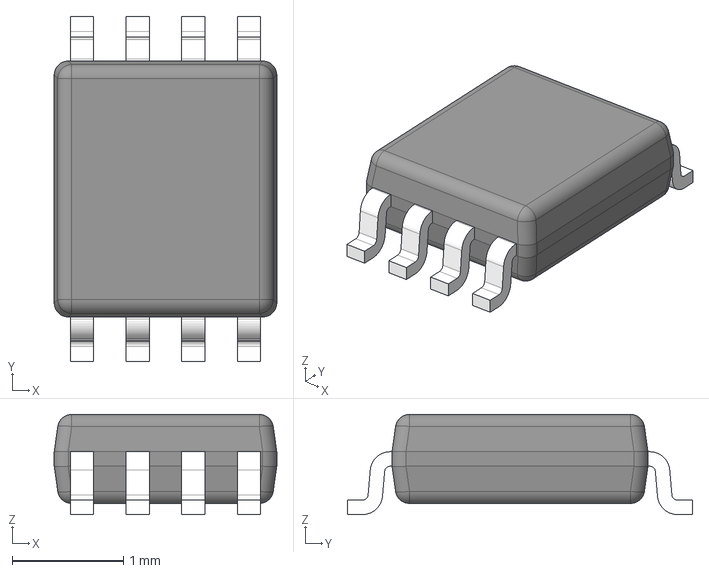
[picture p74: CAD file, 2022-12-09]
models/VSSOP-8.step
2.00 x 3.10 x 0.9 mm
