dnotq/dnotq_kicad_lib/models/MOLEX_DVI-D.step

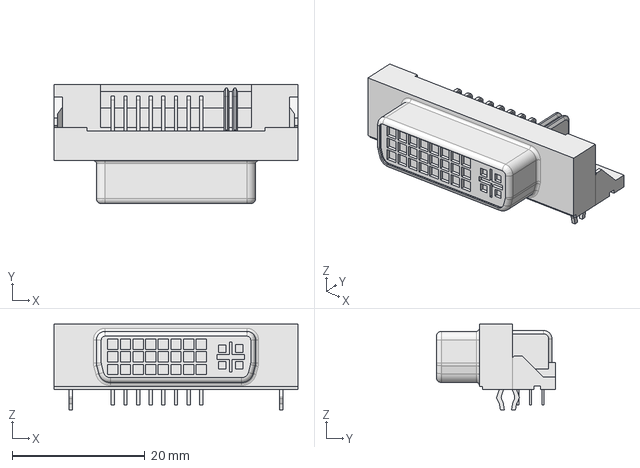
[picture p75: CAD file, 2022-12-09]
models/MOLEX_DVI-D.step
36.8 x 18.0 x 13.0 mm
