dnotq/dnotq_kicad_lib/models/SOIC-8_5.275x5.275mm_P1.27mm.step

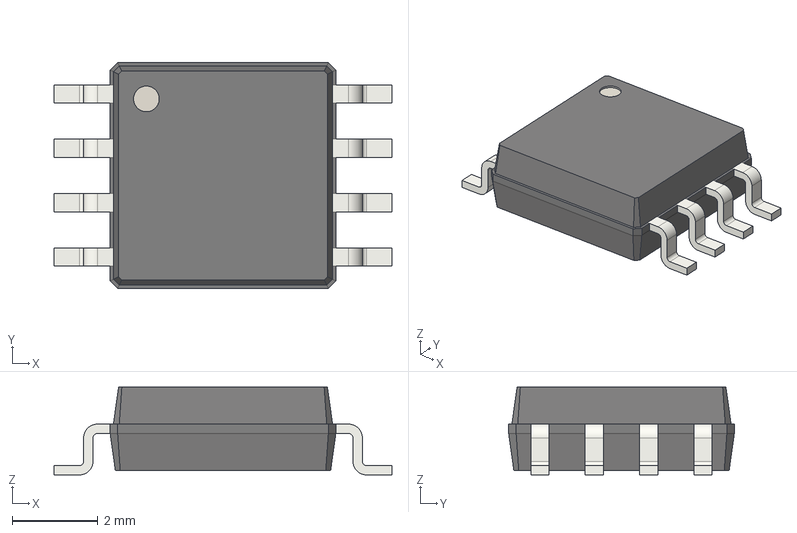
[picture p76: CAD file, 2022-12-09]
models/SOIC-8_5.275x5.275mm_P1.27mm.step
7.90 x 5.28 x 2.06 mm
