dnotq/dnotq_kicad_lib/models/CK_slide_switch_SPDT.step

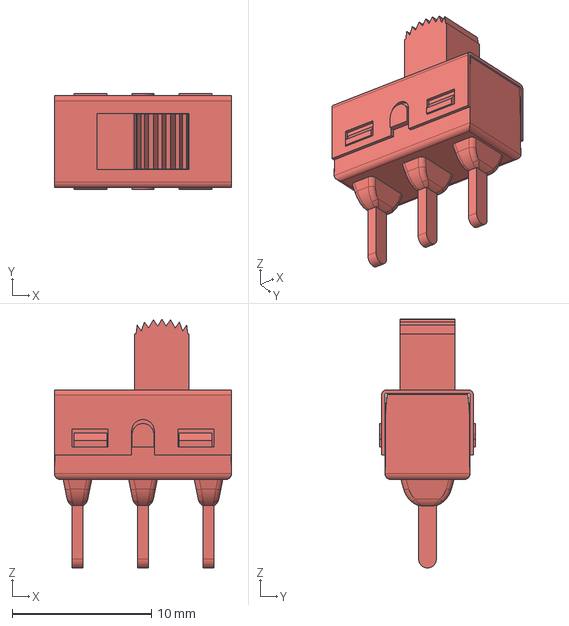
[picture p77: CAD file, 2022-12-09]
models/CK_slide_switch_SPDT.step
12.7 x 6.91 x 17.9 mm
