dnotq/dnotq_kicad_lib/models/BGA_CSG_225.step

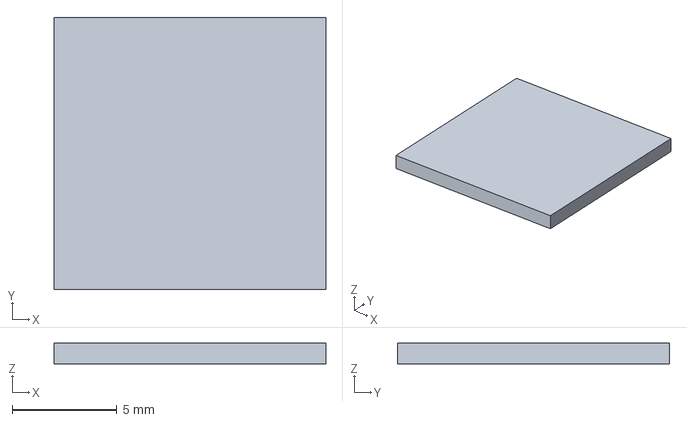
[picture p78: CAD file, 2022-12-09]
models/BGA_CSG_225.step
13.0 x 13.0 x 1.00 mm
