dnotq/dnotq_kicad_lib/models/SW_SPST_EVPAW.step

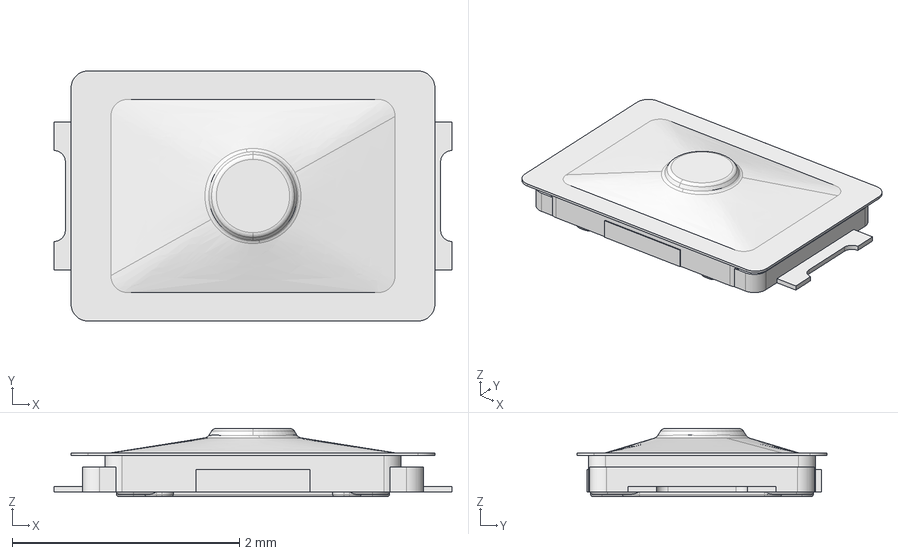
[picture p79: CAD file, 2022-12-09]
models/SW_SPST_EVPAW.step
3.50 x 2.20 x 0.6 mm
