dnotq/dnotq_kicad_lib/models/TLMX_0603_LED.step

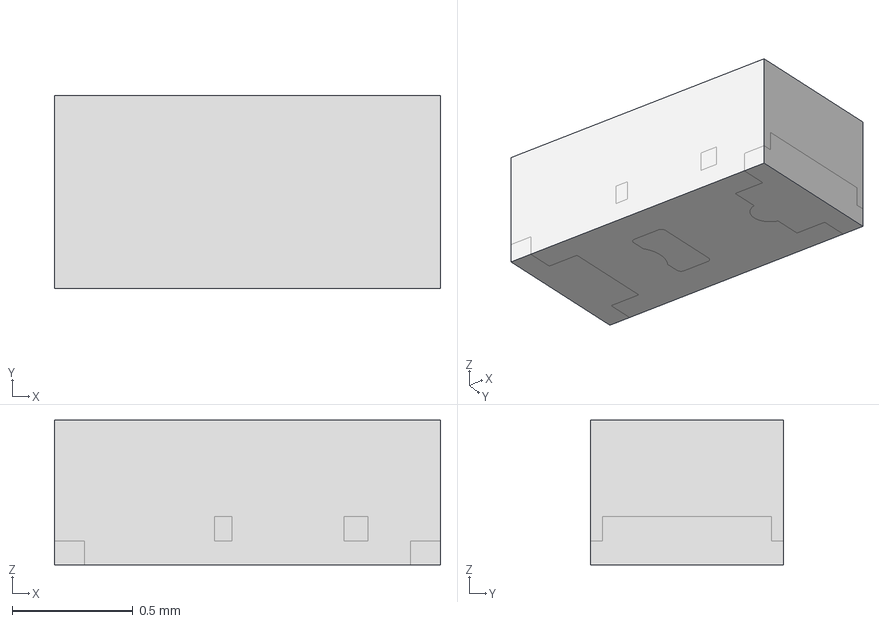
[picture p80: CAD file, 2022-12-09]
models/TLMX_0603_LED.step
1.60 x 0.8 x 0.6 mm
