dnotq/dnotq_kicad_lib/models/WLCSP10-424.step

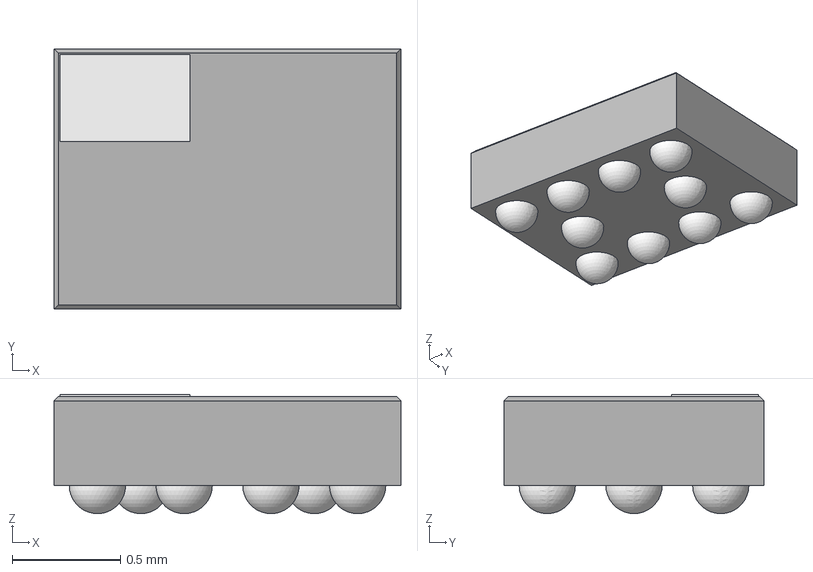
[picture p81: CAD file, 2022-12-09]
models/WLCSP10-424.step
1.60 x 1.20 x 0.55 mm
