dnotq/dnotq_kicad_lib/models/QFN20_2.5x4.5mm_P0.5.step

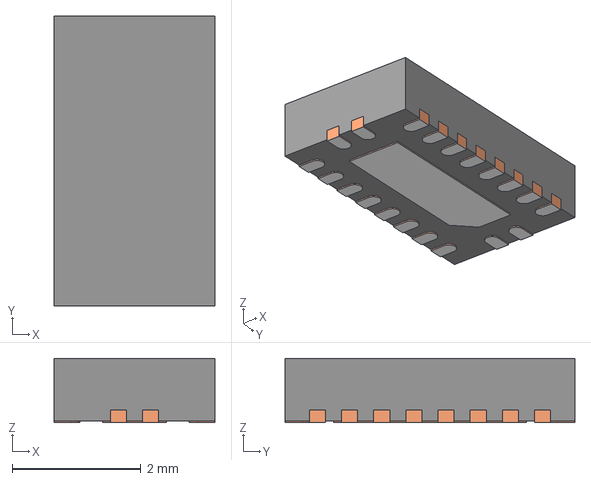
[picture p82: CAD file, 2022-12-09]
models/QFN20_2.5x4.5mm_P0.5.step
2.50 x 4.50 x 1.00 mm
