dnotq/dnotq_kicad_lib/models/FCI_plug_10132797-031100LF.step

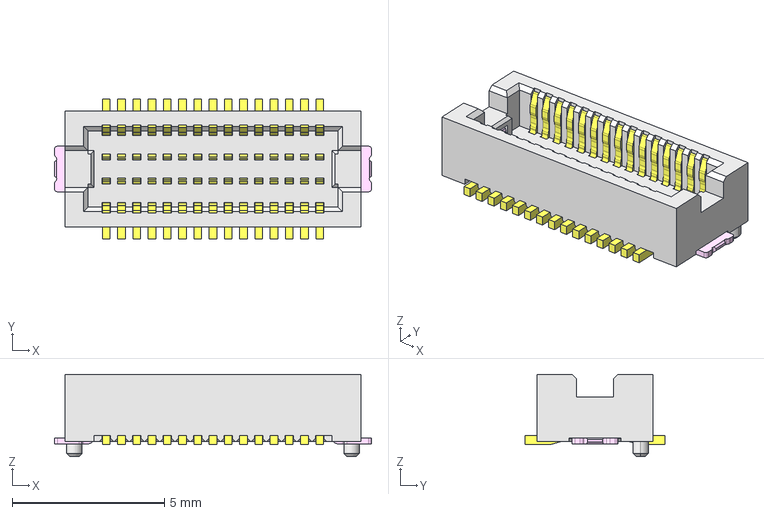
[picture p83: CAD file, 2022-12-09]
models/FCI_plug_10132797-031100LF.step
10.4 x 4.60 x 2.70 mm
