dnotq/dnotq_kicad_lib/models/SOIC-8_3.9x4.9mm_P1.27mm.step

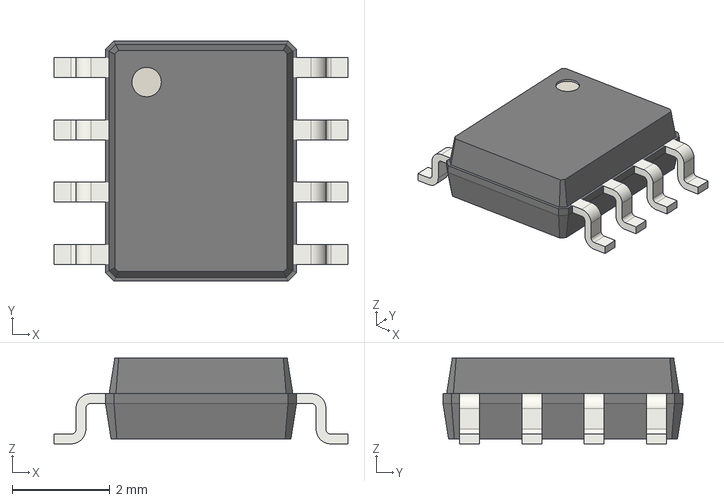
[picture p84: CAD file, 2022-12-09]
models/SOIC-8_3.9x4.9mm_P1.27mm.step
6.00 x 4.90 x 1.75 mm
