dnotq/dnotq_kicad_lib/models/TVSOP-24.step

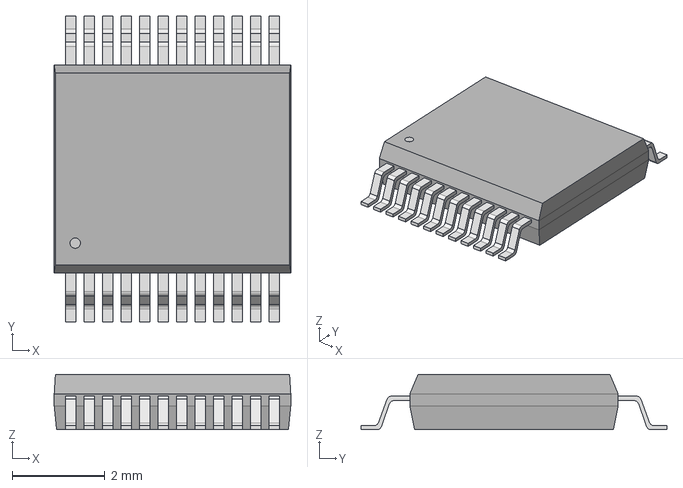
[picture p85: CAD file, 2022-12-09]
models/TVSOP-24.step
5.11 x 6.60 x 1.20 mm
