dnotq/dnotq_kicad_lib/models/DIP-40_W15.24mm_Socket.step

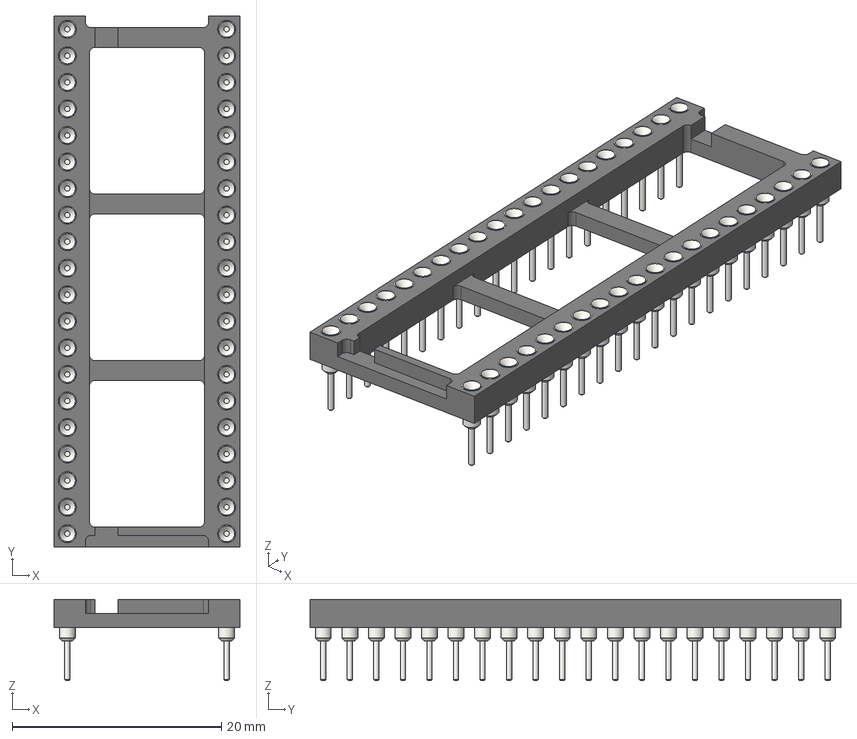
[picture p86: CAD file, 2022-12-09]
models/DIP-40_W15.24mm_Socket.step
17.8 x 50.8 x 7.79 mm
