dnotq/dnotq_kicad_lib/(list of files, cad)

Other CAD files:
models/Keystone-621_bottom.step
