dnotq/dnotq_kicad_lib/(commit log)

2022-12-09 Updated 0402 to have 0.2mm keep-out.
2022-12-09 Added WRL and STEP models.
    [ASA_QFN_2.0x1.6.step, ASE_QFN4_3.2x2.5.step, BGA_CSG_225.step, BatteryHolder_Keystone_3034_1x20mm.step, CK_SWITCH_101M2S3CQE011.step, CK_slide_switch_SPDT.step, CUI_SJ-3523-SMT-TR.step, Crystal_SMD_3215_2Pin_3_2x1_5mm.step]
2023-02-13 More parts.
    [3M_TEXTOOL_ZIF_40DIP.step, HIROSE_FH34SRJ-22S-0.5SH.step]
2023-10-01 Added Trion T20 symbol and footprint. Added WSON-6 footprint for TI regulator. Updated symbols and footprints based on current whims (subject to change in the future).
2025-04-14 Moved the library folders around, added some new parts, made a mess of the readme.
    [C_0201_0603Metric.step, C_0402_1005Metric.step, C_0603_1608Metric.step, C_0805_2012Metric.step, DFN-6_1.2x1.3mm_P0.4mm.step, D_SOD-523.step, D_SOD-882.step, LED_D3.0mm.step]
2026-05-12 Updated to KiCad 10. Renamed dir to footprints. Added some models.
    [Molex_053261-0271_2pos_1.25mm_ra_smd.stp, Seiko_Epson_MC-306_8x3.8mm.step, Seiko_Epston_FC-135R_crystal.step]
2026-05-12 Rearranged library to use KiCad 10 features.
2026-05-12 Removed all wrl files and changed footprints to reference step files.
2026-05-12 Changed footprints to only use DNOTQ_DIR.
2026-05-12 Updated symbol footprint references.
2026-05-13 Commit latest prior to pulling reorganized lib.
    [Molex_053261-0271_2pos_1.25mm_ra_smd.stp]
2026-05-13 Added new footprint and model.
    [Molex_053261-0271_2pos_1.25mm_ra_smd.step]
2026-08-23 Added Apple2 symbols and footprints
2026-08-23 Added Apple2 symbols and footprint dirs
