dnotq/dnotq_kicad_lib/(notices)

Notices in the files:
models/SOIC-14_3.9x8.7mm_P1.27mm.step:
Copyright (C) 2017, kicad StepUp
This work is licensed under the [Creative Commons CC-BY-SA 4.0 License](https://creativecommons.org/licenses/by-sa/4.0/legalcode),
with the following exception:
To the extent that the creation of electronic designs that use 'Licensed Material' can be considered to be 'Adapted Material',
You are free to use the library data in your own projects without the obligation to share your project files under this or any other license agreement.
models/LED_0603_1608Metric.step:
Copyright (C) 2018, kicad StepUp
models/D_SOD-523.step:
This program is free software: you can redistribute it and/or modify
it under the terms of the GNU General Public License as published by
the Free Software Foundation, either version 3 of the License, or
any later version.
itself might be covered by the GNU General Public License.
models/WSON-6-1EP_2x2mm_P0.65mm_EP1x1.6mm.step:
Copyright (C) 2020, kicad StepUp
models/DIP-40_W15.24mm_Socket.step:
Copyright (C) 2017, Terje Io
models/SOIC-8_5.275x5.275mm_P1.27mm.step:
Copyright (C) 2019, kicad StepUp
models/PinSocket_2x06_P2.54mm_Horizontal.step:
This work is licensed under the Creative Commons CC-BY-SA 4.0 License with the following exception:
To the extent that the creation of electronic designs that use 'Licensed Material'
https://creativecommons.org/licenses/by-sa/4.0/legalcode
models/D_SOD-882.step:
Copyright (C) 2024, KiCAD
This work is licensed under the
[Creative Commons CC-BY-SA 4.0 License](https://creativecommons.org/licenses/by-sa/4.0/legalcode),
project files under this or any other license agreement. However, if you wish to distribute
models/TO-263-3_TabPin2.step:
Copyright (C) 2023, Ray Benitez
